VortacDesign/VortacToolchanger/README.md

# VortacToolchanger
Modular toolchanger system for 3D printers – designed for VORON-style machines. Includes mechanical files, wiring guides, firmware configuration and setup scripts.
