VortacDesign/VortacToolchanger/pcb/Vectors/Robi.png

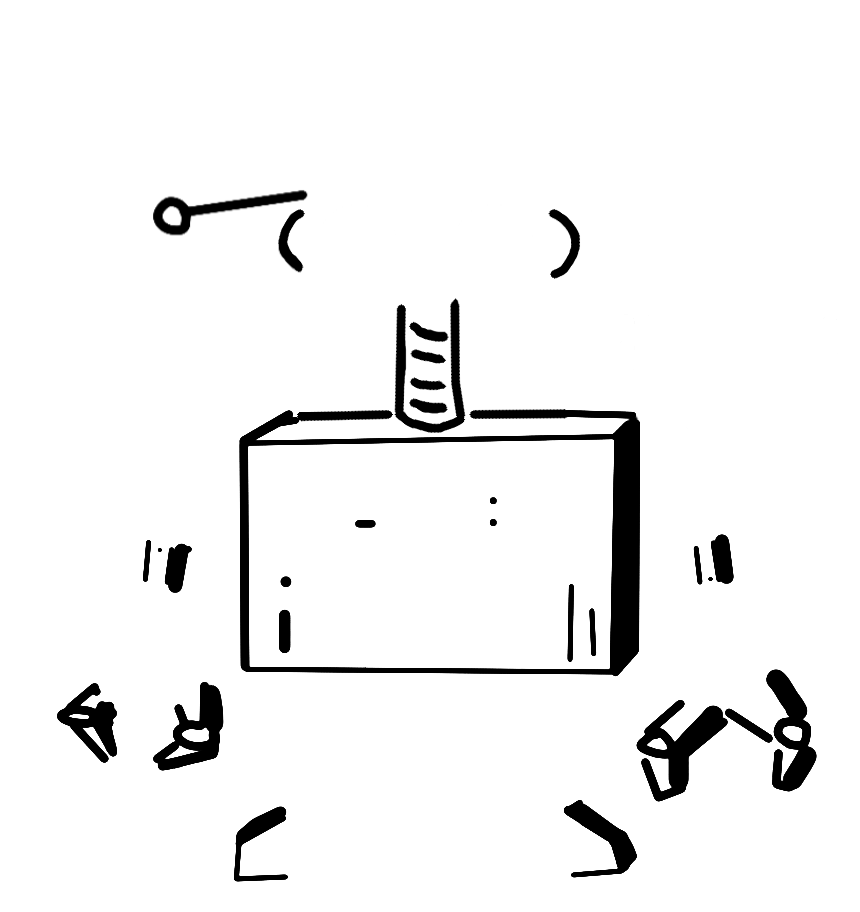
pcb/Vectors/Robi.png
