VortacDesign/VortacToolchanger/pcb/KiCAD/VORTAC_TOOL/production/bom.csv

Designator | Footprint | Quantity | Value | LCSC Part #
D1, D2 | D_SOD-323 | 2 | UDD32C24L01 | C19188728
D5 | D_SOD-123F | 1 | PTVS26VS1UR,115-ES | C41409305
