VortacDesign/VortacToolchanger/pcb/Vectors/PCB  Main.dxf

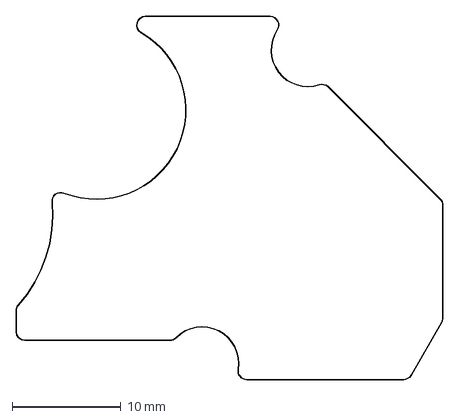
[picture p2: CAD file, 2025-06-08]
pcb/Vectors/PCB Main.dxf
39.2 x 33.4 mm
