VortacDesign/VortacToolchanger/pcb/KiCAD/VORTAC_DOCK_REV1/VORTAC_DOCK_REV1.step

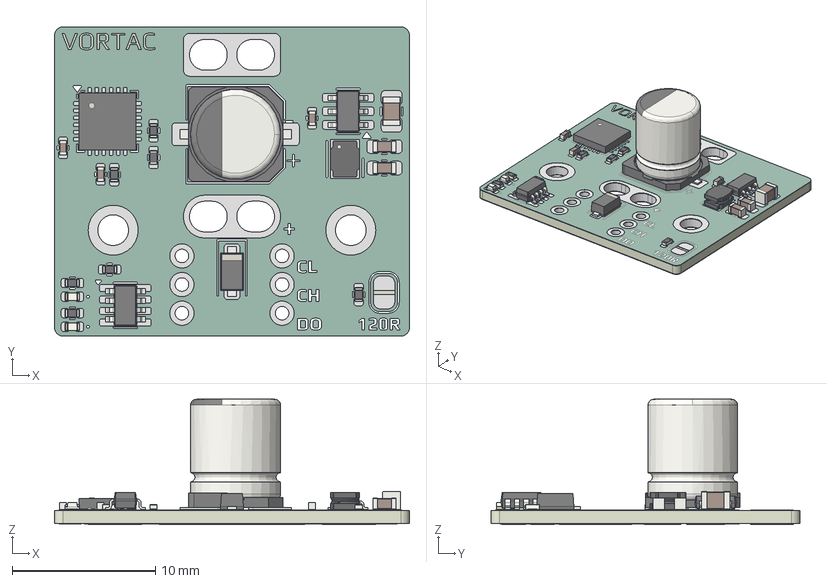
[picture p3: CAD file, 2026-04-23]
pcb/KiCAD/VORTAC_DOCK_REV1/VORTAC_DOCK_REV1.step
24.8 x 21.6 x 8.77 mm
C_0402_1005Metric x 3
R_0402_1005Metric x 7
CP_Elec_6.3x7.7
C_0805_2012Metric
LED_0402_1005Metric x 2
C_0603_1608Metric x 2
D_SOD-123F
SOT-23-8
Texas_RGE0024H_VQFN-24-1EP_4x4mm_P0.5mm_EP2.7x2.7mm
L_Wurth_WE-LQSH-2512
TSOT-23-6
VORTAC_DOCK_REV1_copper
VORTAC_DOCK_REV1_pad
VORTAC_DOCK_REV1_via
VORTAC_DOCK_REV1_silkscreen
VORTAC_DOCK_REV1_soldermask
VORTAC_DOCK_REV1_PCB
