VortacDesign/VortacToolchanger/pcb/KiCAD/VORTAC_PANEL_REV1/production/Panel_DXF.dxf

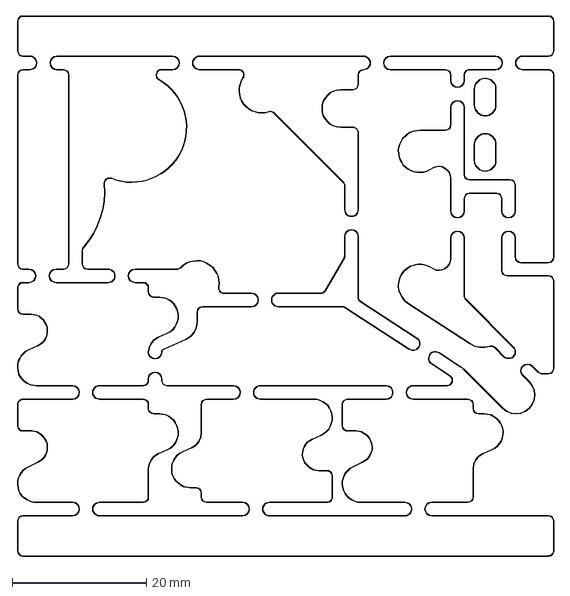
[picture p4: CAD file, 2025-06-08]
pcb/KiCAD/VORTAC_PANEL_REV1/production/Panel_DXF.dxf
80.2 x 80.6 mm
