VortacDesign/VortacToolchanger/pcb/KiCAD/VORTAC_REV1/VORTAC_REV1.step

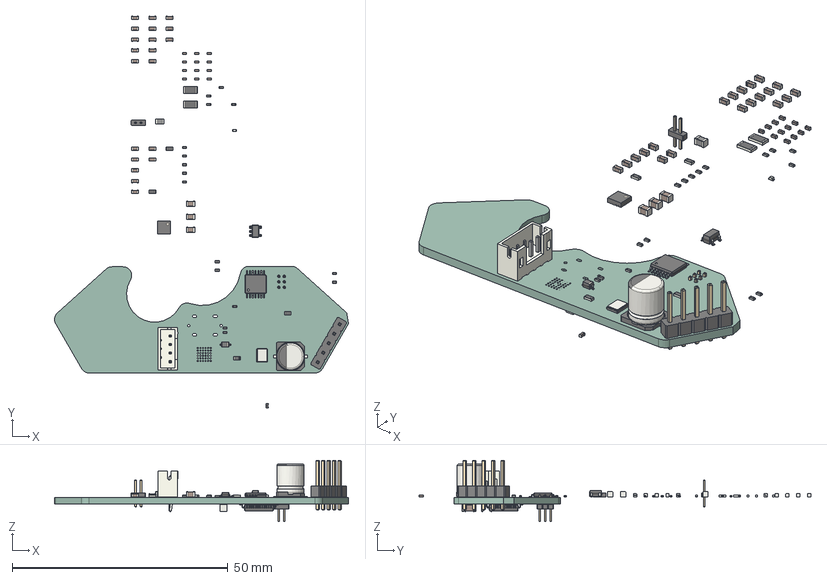
[picture p5: CAD file, 2025-06-08]
pcb/KiCAD/VORTAC_REV1/VORTAC_REV1.step
68.2 x 90.8 x 14.2 mm
C_0805_2012Metric x 3
C_0603_1608Metric x 20
C_0402_1005Metric x 13
R_0402_1005Metric x 19
CP_Elec_63x77
L_0805_2012Metric
R_1206_3216Metric x 2
R_0603_1608Metric x 4
SOT_23_5
D_SOD_323
VSON_10_1EP_3x3mm_Pitch05mm_ThermalPad
PinHeader_2x01_P127mm_Vertical
TSSOP_14_44x5mm_P065mm
LED_0402_1005Metric
JST_B4B_PH_K
PinHeader_1x05_P254mm_Vertical
Crystal_SMD_3225-4Pin_3.2x2.5mm
LQFP_48_7x7mm_P05mm
PinHeader_2x03_P127mm_Vertical
C_1206_3216Metric
_autosave-VORTAC_REV1_PCB
