VortacDesign/VortacToolchanger/pcb/KiCAD/VORTAC_TOOL/VORTAC_TOOL.step

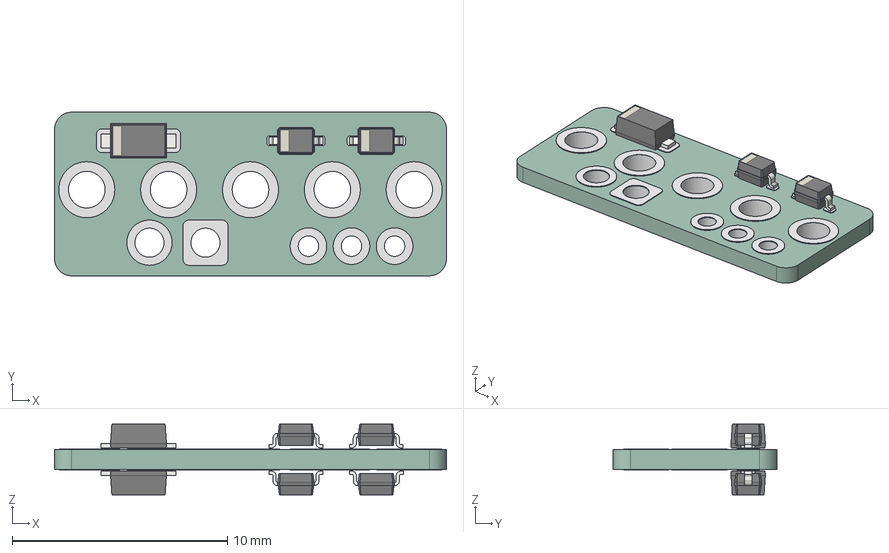
[picture p6: CAD file, 2026-04-22]
pcb/KiCAD/VORTAC_TOOL/VORTAC_TOOL.step
18.2 x 7.60 x 3.28 mm
D_SOD-323 x 4
D_SOD-123F x 2
VORTAC_TOOL_pad
VORTAC_TOOL_PCB
