VortacDesign/VortacToolchanger/pcb/KiCAD/VORTAC_TOOLPLATE_REV2/VORTAC_TOOLPLATE_REV2.step

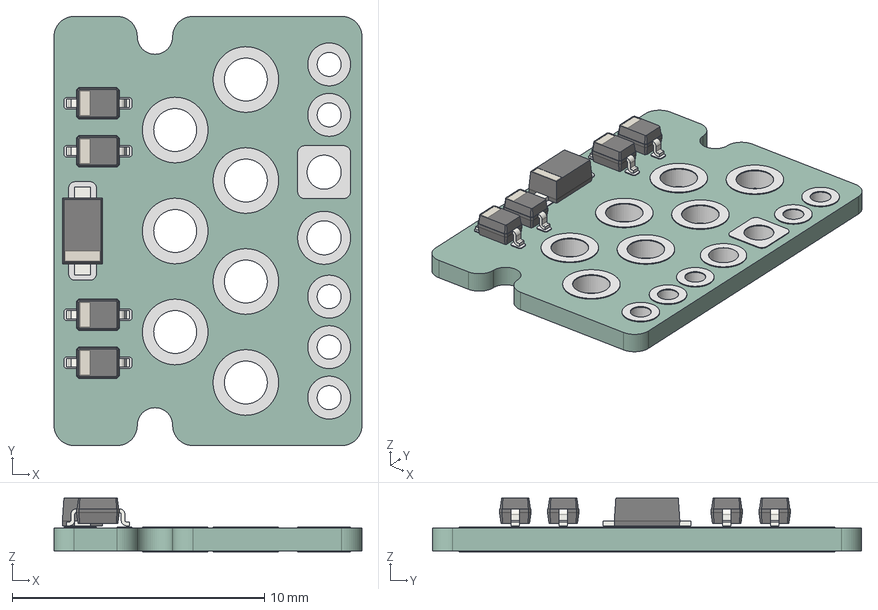
[picture p7: CAD file, 2025-11-01]
pcb/KiCAD/VORTAC_TOOLPLATE_REV2/VORTAC_TOOLPLATE_REV2.step
12.2 x 17.0 x 2.14 mm
D_SOD-323 x 4
D_SOD-123F
VORTAC_TOOLPLATE_REV2_pad
VORTAC_TOOLPLATE_REV2_PCB
