VortacDesign/VortacToolchanger/stl/Vortac_Dock_02_Frame.stl

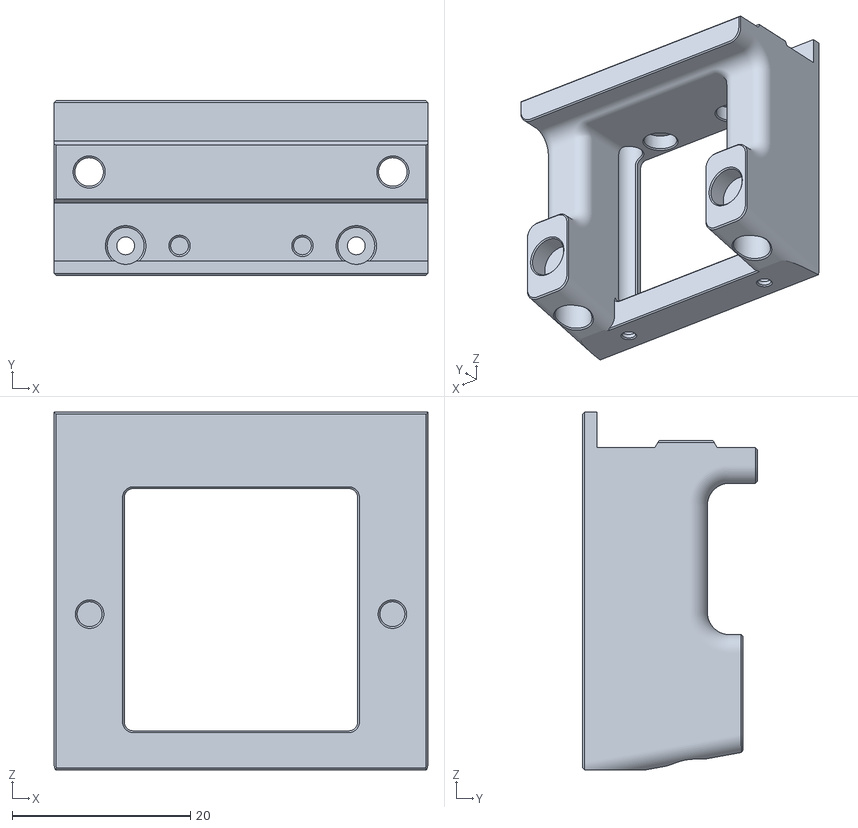
[picture p8: CAD file, 2026-04-23]
stl/Vortac_Dock_02_Frame.stl
42.0 x 19.6 x 40.2
