VortacDesign/VortacToolchanger/pcb/KiCAD/VORTAC_DOCK_REV1/SolderJig_Magnets.stl

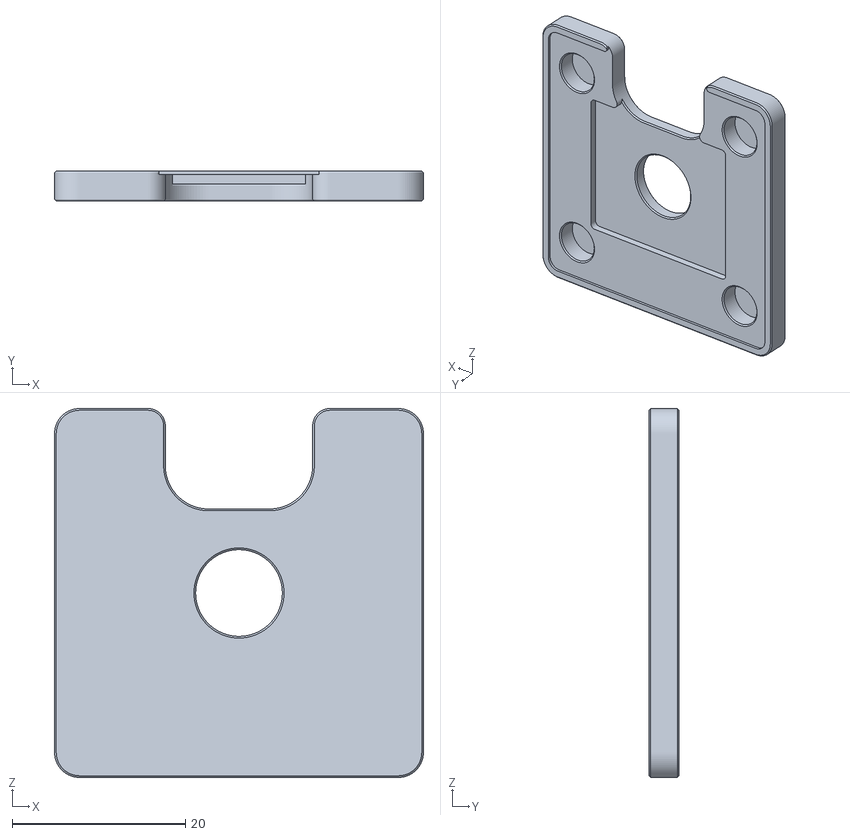
[picture p9: CAD file, 2026-04-22]
pcb/KiCAD/VORTAC_DOCK_REV1/SolderJig_Magnets.stl
42.6 x 3.50 x 42.6
