VortacDesign/VortacToolchanger/pcb/KiCAD/VORTAC_TOOL/OutLine.dxf

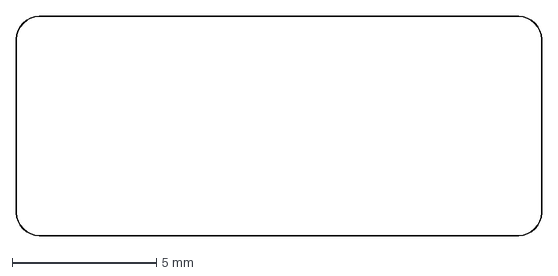
[picture p10: CAD file, 2025-10-04]
pcb/KiCAD/VORTAC_TOOL/OutLine.dxf
18.2 x 7.60 mm
