VortacDesign/VortacToolchanger/pcb/KiCAD/VORTAC_TOOLPLATE_REV2/PCB_Refference.dxf

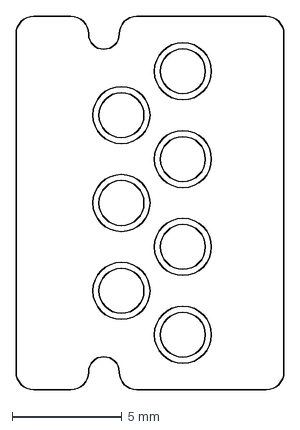
[picture p11: CAD file, 2025-11-01]
pcb/KiCAD/VORTAC_TOOLPLATE_REV2/PCB_Refference.dxf
12.2 x 17.0 mm
