VortacDesign/VortacToolchanger/pcb/Vectors/PCB Clearance.dxf

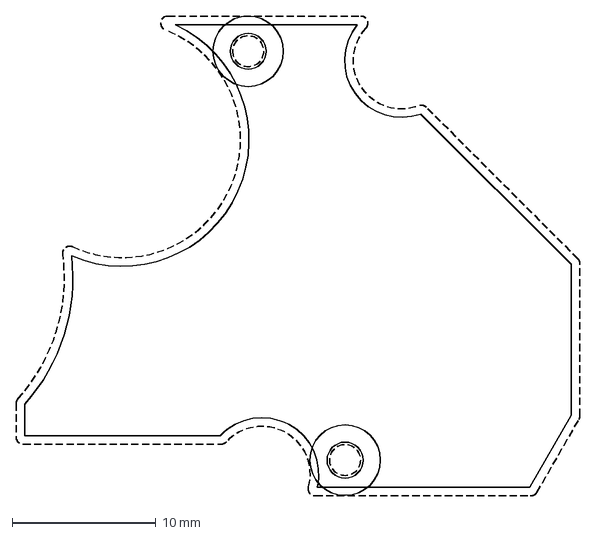
[picture p12: CAD file, 2025-06-08]
pcb/Vectors/PCB Clearance.dxf
39.2 x 33.4 mm
