VortacDesign/VortacToolchanger/stl/Vortac_Dock_02_PogoBar.stl

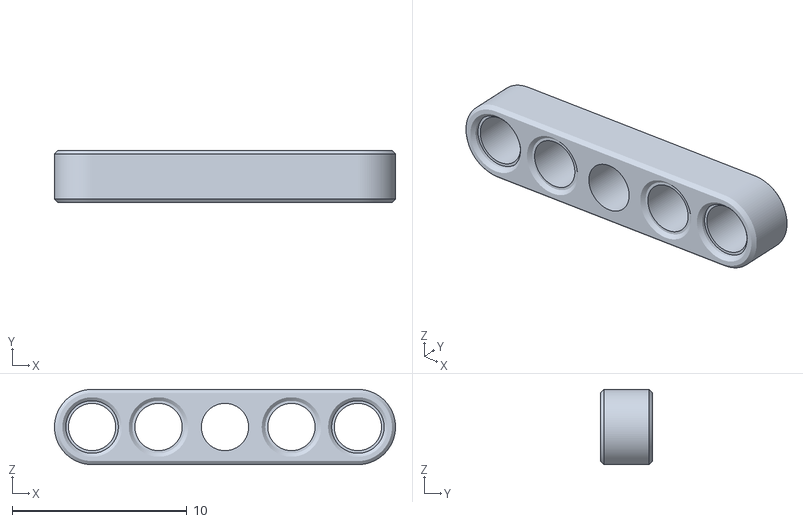
[picture p13: CAD file, 2026-04-23]
stl/Vortac_Dock_02_PogoBar.stl
19.5 x 3.00 x 4.30
