VortacDesign/VortacToolchanger/pcb/KiCAD/VORTAC_DOCK_REV1/SolderJig.stl

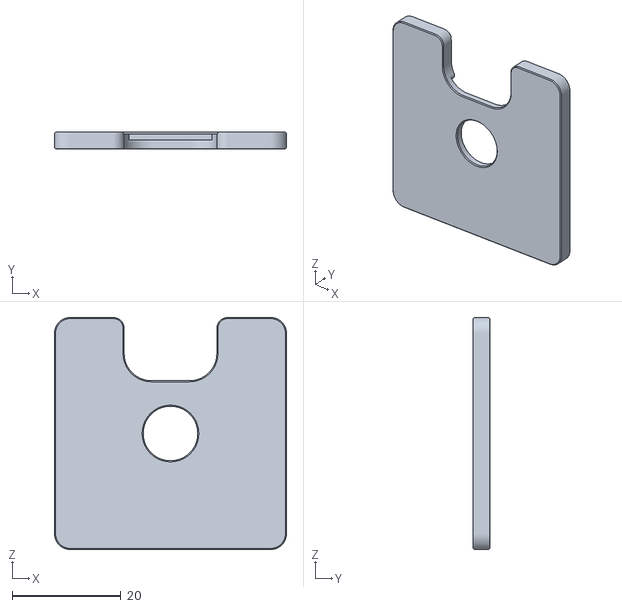
[picture p14: CAD file, 2026-04-22]
pcb/KiCAD/VORTAC_DOCK_REV1/SolderJig.stl
42.6 x 3.10 x 42.6
