VortacDesign/VortacToolchanger/pcb/Vectors/Vortac_Logo.dxf

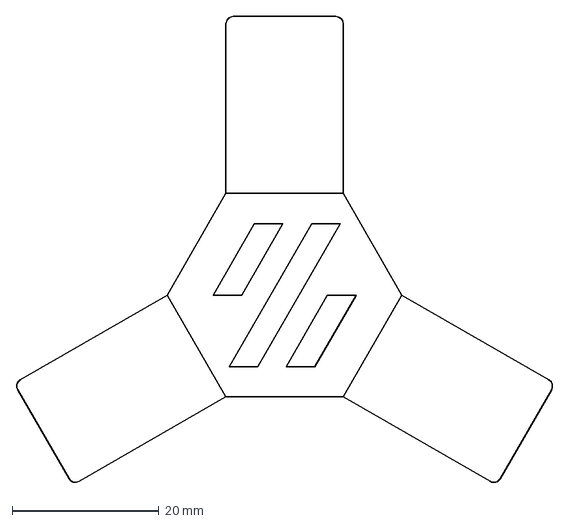
[picture p16: CAD file, 2025-06-08]
pcb/Vectors/Vortac_Logo.dxf
73.3 x 63.7 mm
