VortacDesign/VortacToolchanger/stl/Vortac_Dock_02_Slider.stl

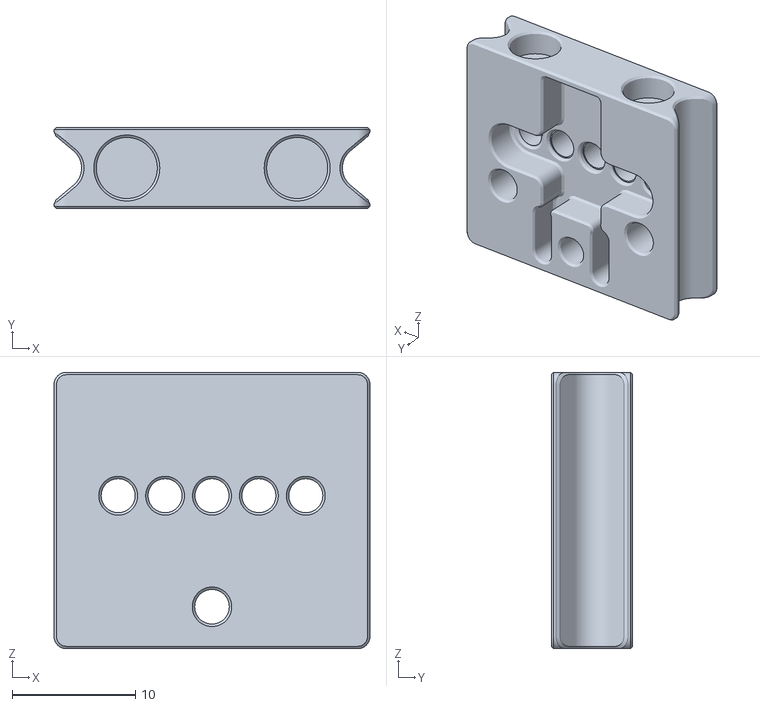
[picture p17: CAD file, 2026-04-23]
stl/Vortac_Dock_02_Slider.stl
25.6 x 6.60 x 22.4
