VortacDesign/VortacToolchanger/pcb/KiCAD/VORTAC_DOCK_REV1/SolderJig_spachelor.stl

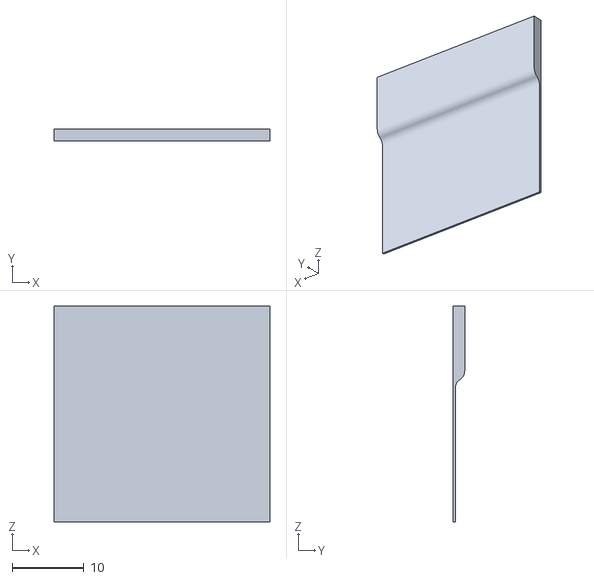
[picture p18: CAD file, 2026-04-22]
pcb/KiCAD/VORTAC_DOCK_REV1/SolderJig_spachelor.stl
30.0 x 1.60 x 30.0
