VortacDesign/VortacToolchanger/pcb/Vectors/PCB Tool.dxf

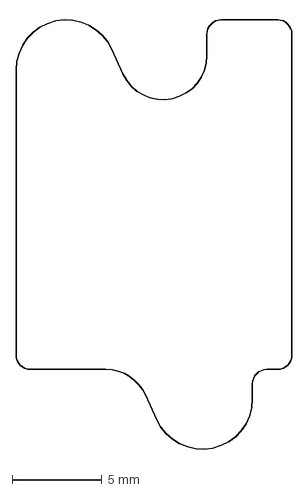
[picture p19: CAD file, 2025-06-08]
pcb/Vectors/PCB Tool.dxf
15.4 x 24.4 mm
