VortacDesign/VortacToolchanger/stl/Vortac_Topplate_003.stl

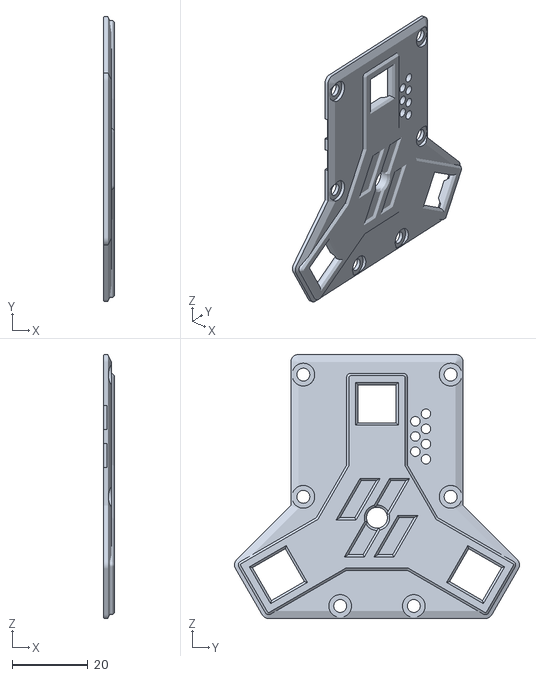
[picture p20: CAD file, 2025-10-04]
stl/Vortac_Topplate_003.stl
3.00 x 75.1 x 69.6
