VortacDesign/VortacToolchanger/pcb/KiCAD/VORTAC_DOCK_REV1/PCB_Outline.dxf

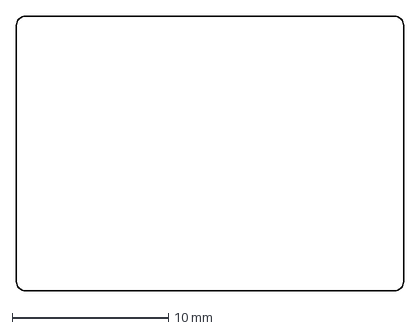
[picture p21: CAD file, 2025-10-30]
pcb/KiCAD/VORTAC_DOCK_REV1/PCB_Outline.dxf
24.8 x 17.6 mm
