VortacDesign/VortacToolchanger/pcb/Vectors/Vortac_Toolchanger_Logo.dxf

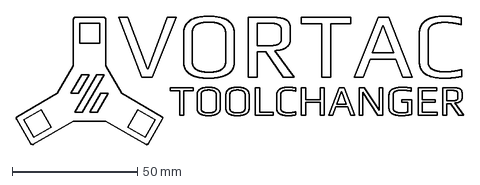
[picture p22: CAD file, 2025-06-08]
pcb/Vectors/Vortac_Toolchanger_Logo.dxf
178.7 x 51.4 mm
