VortacDesign/VortacToolchanger/stl/Vortac_Baseplate_003.stl

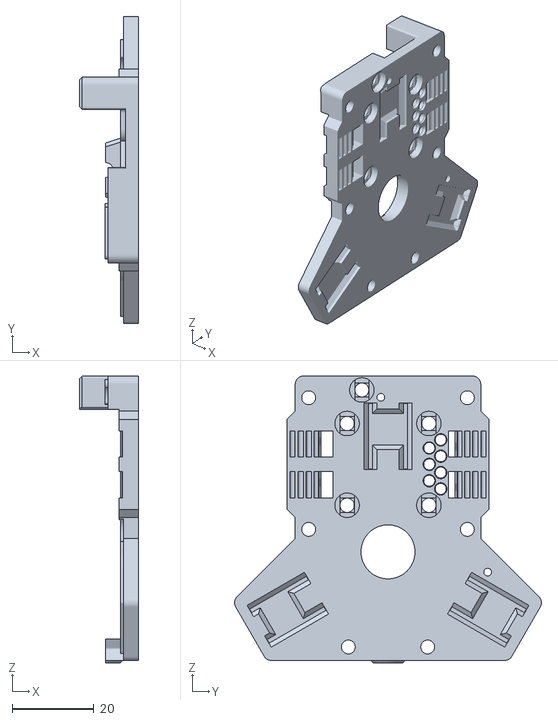
[picture p23: CAD file, 2025-10-04]
stl/Vortac_Baseplate_003.stl
14.4 x 75.1 x 70.2
