VortacDesign/VortacToolchanger/pcb/Vectors/PanelCenter.dxf

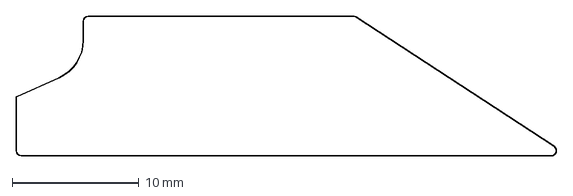
[picture p25: CAD file, 2025-06-08]
pcb/Vectors/PanelCenter.dxf
42.6 x 11.0 mm
