VortacDesign/VortacToolchanger/stl/Vortac_Cable_Anchor_001.stl

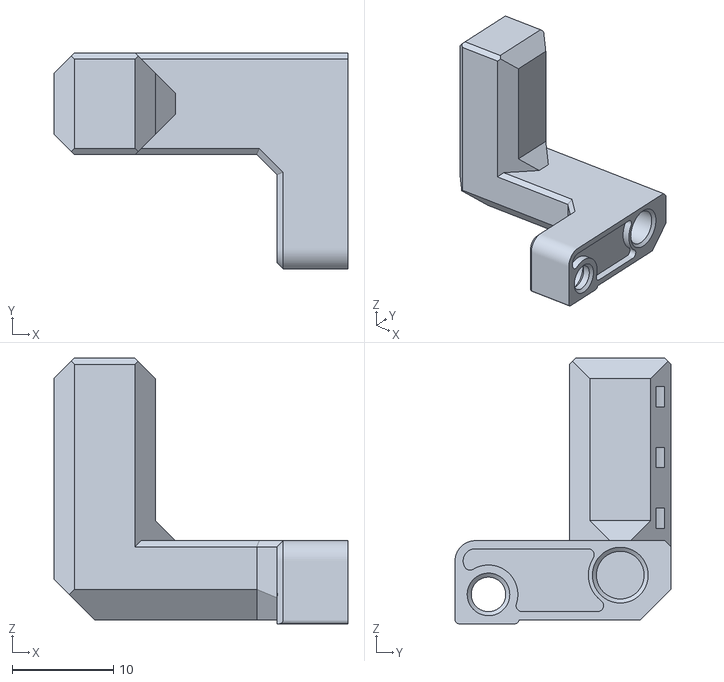
[picture p26: CAD file, 2025-10-04]
stl/Vortac_Cable_Anchor_001.stl
29.0 x 21.3 x 26.2
