VortacDesign/VortacToolchanger/pcb/Vectors/PCB Front.dxf

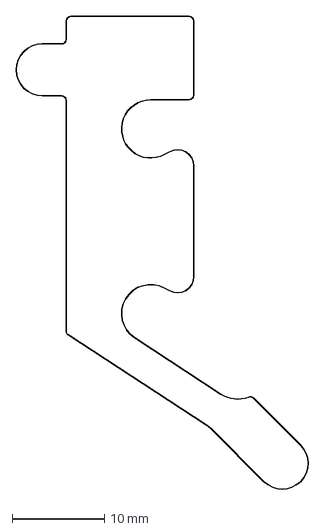
[picture p27: CAD file, 2025-06-08]
pcb/Vectors/PCB Front.dxf
31.9 x 51.5 mm
