VortacDesign/VortacToolchanger/stl/Vortac_001_Back.stl

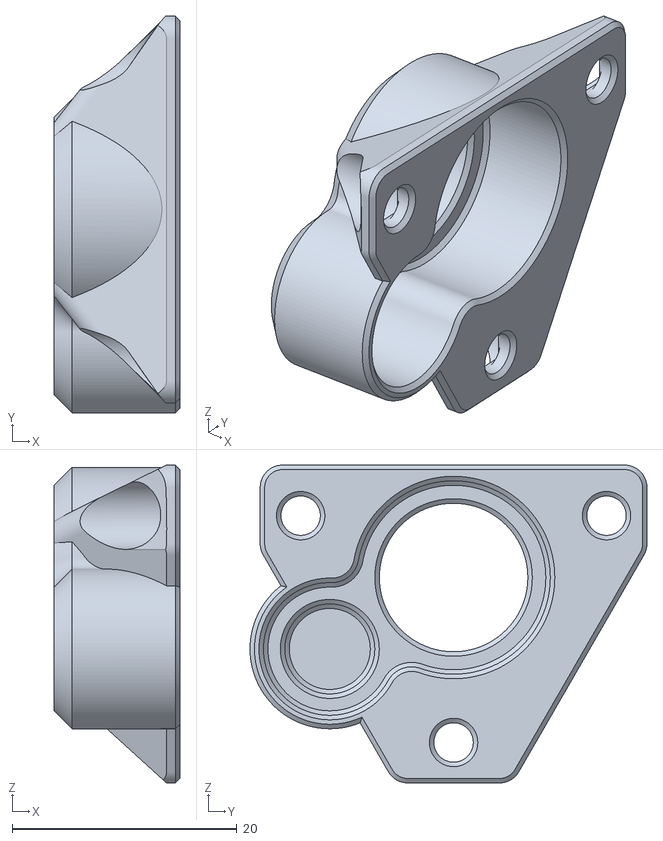
[picture p28: CAD file, 2025-06-09]
stl/Vortac_001_Back.stl
11.2 x 35.3 x 28.3
