VortacDesign/VortacToolchanger/stl/Sensor_Guide.stl

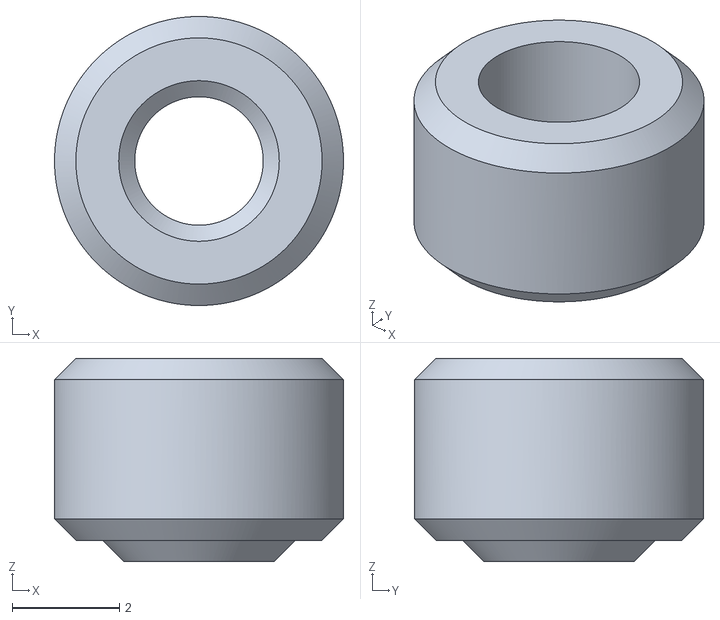
[picture p30: CAD file, 2025-06-09]
stl/Sensor_Guide.stl
5.40 x 5.40 x 3.80
