VortacDesign/VortacToolchanger/stl/Vortac_003_Mid.stl

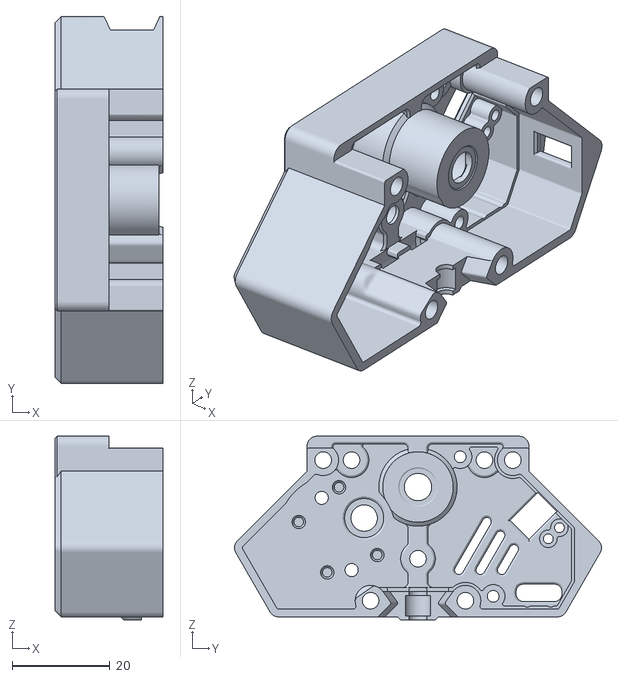
[picture p31: CAD file, 2025-06-09]
stl/Vortac_003_Mid.stl
22.0 x 75.1 x 37.6
