VortacDesign/VortacToolchanger/stl/Vortac_001_Top.stl

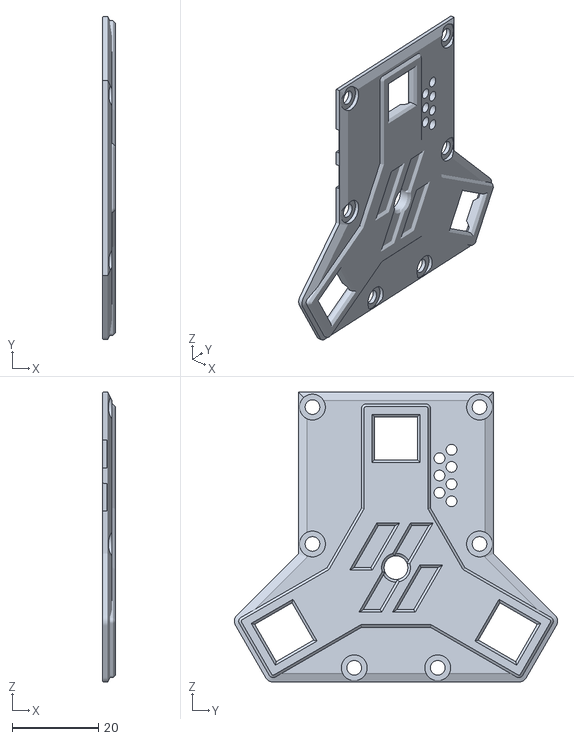
[picture p32: CAD file, 2025-06-09]
stl/Vortac_001_Top.stl
3.00 x 75.1 x 67.4
