VortacDesign/VortacToolchanger/stl/JointX_L_Top_V3.stl

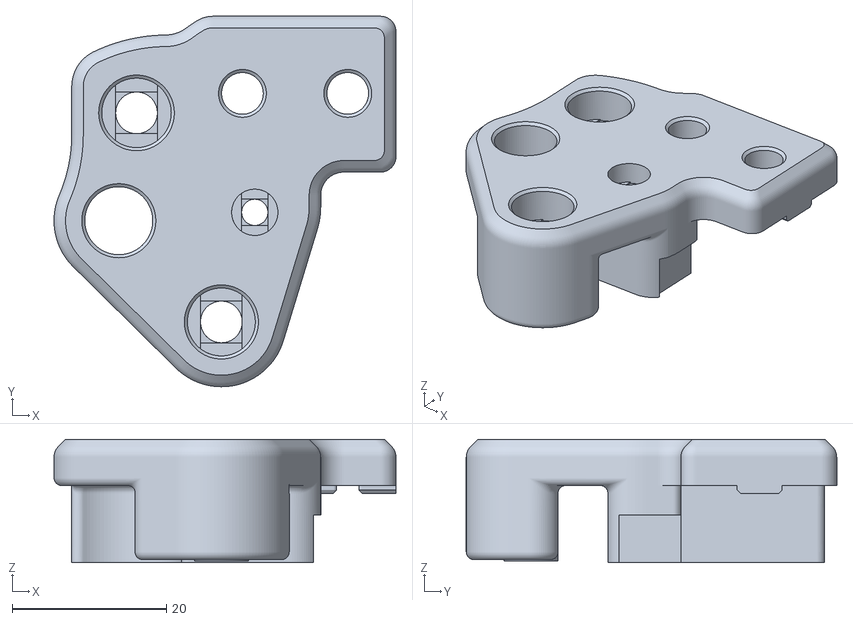
[picture p33: CAD file, 2025-06-09]
stl/JointX_L_Top_V3.stl
44.3 x 48.0 x 16.0
