VortacDesign/VortacToolchanger/stl/JointX_L_Bot_V3.stl

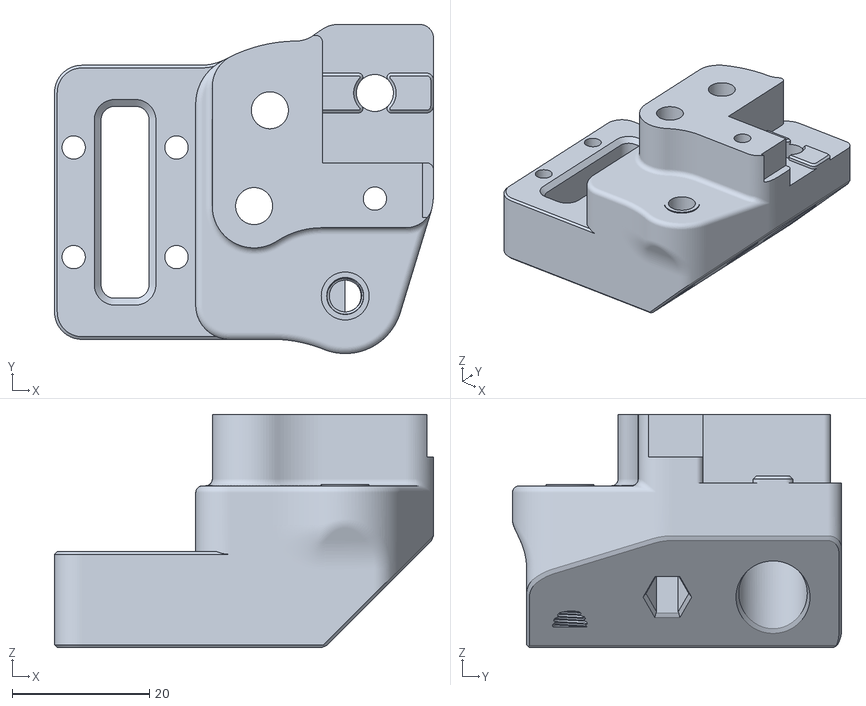
[picture p34: CAD file, 2025-06-09]
stl/JointX_L_Bot_V3.stl
55.3 x 48.0 x 34.0
