VortacDesign/VortacToolchanger/stl/Vortac_Toolplate_002.stl

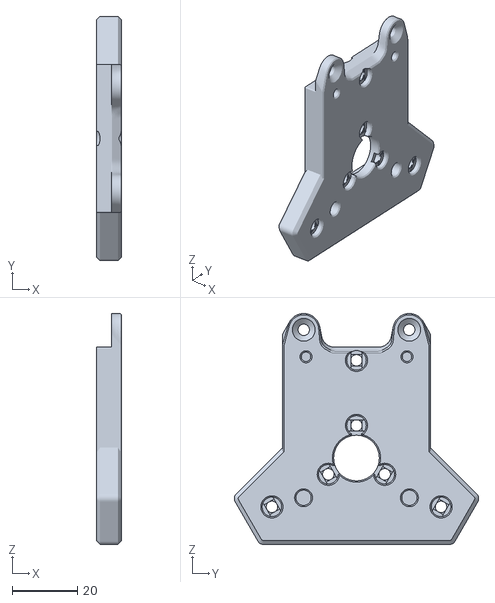
[picture p35: CAD file, 2025-06-09]
stl/Vortac_Toolplate_002.stl
7.80 x 75.1 x 70.9
