VortacDesign/VortacToolchanger/stl/Sensor_Flag.stl

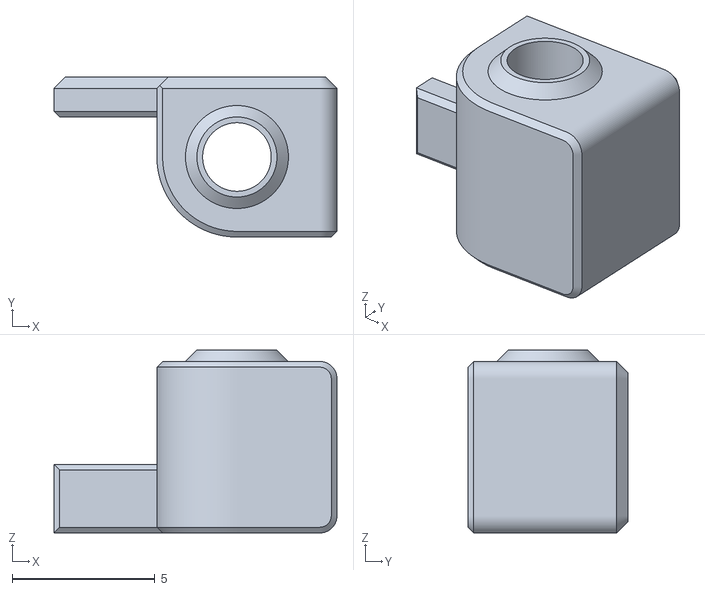
[picture p37: CAD file, 2025-06-09]
stl/Sensor_Flag.stl
9.90 x 5.60 x 6.40
