VortacDesign/VortacToolchanger/(list of files, cad)

Other CAD files:
pcb/KiCAD/VORTAC_TOOLPLATE_REV1/VORTAC_TOOLPLATE_REV1.step
