VortacDesign/VortacToolchanger/pcb/KiCAD/VORTAC_DOCK_REV1/VORTAC_DOCK_REV1.kicad_pcb

## KiCad design pcb/KiCAD/VORTAC_DOCK_REV1/VORTAC_DOCK_REV1.kicad_pcb (2026-04-22)

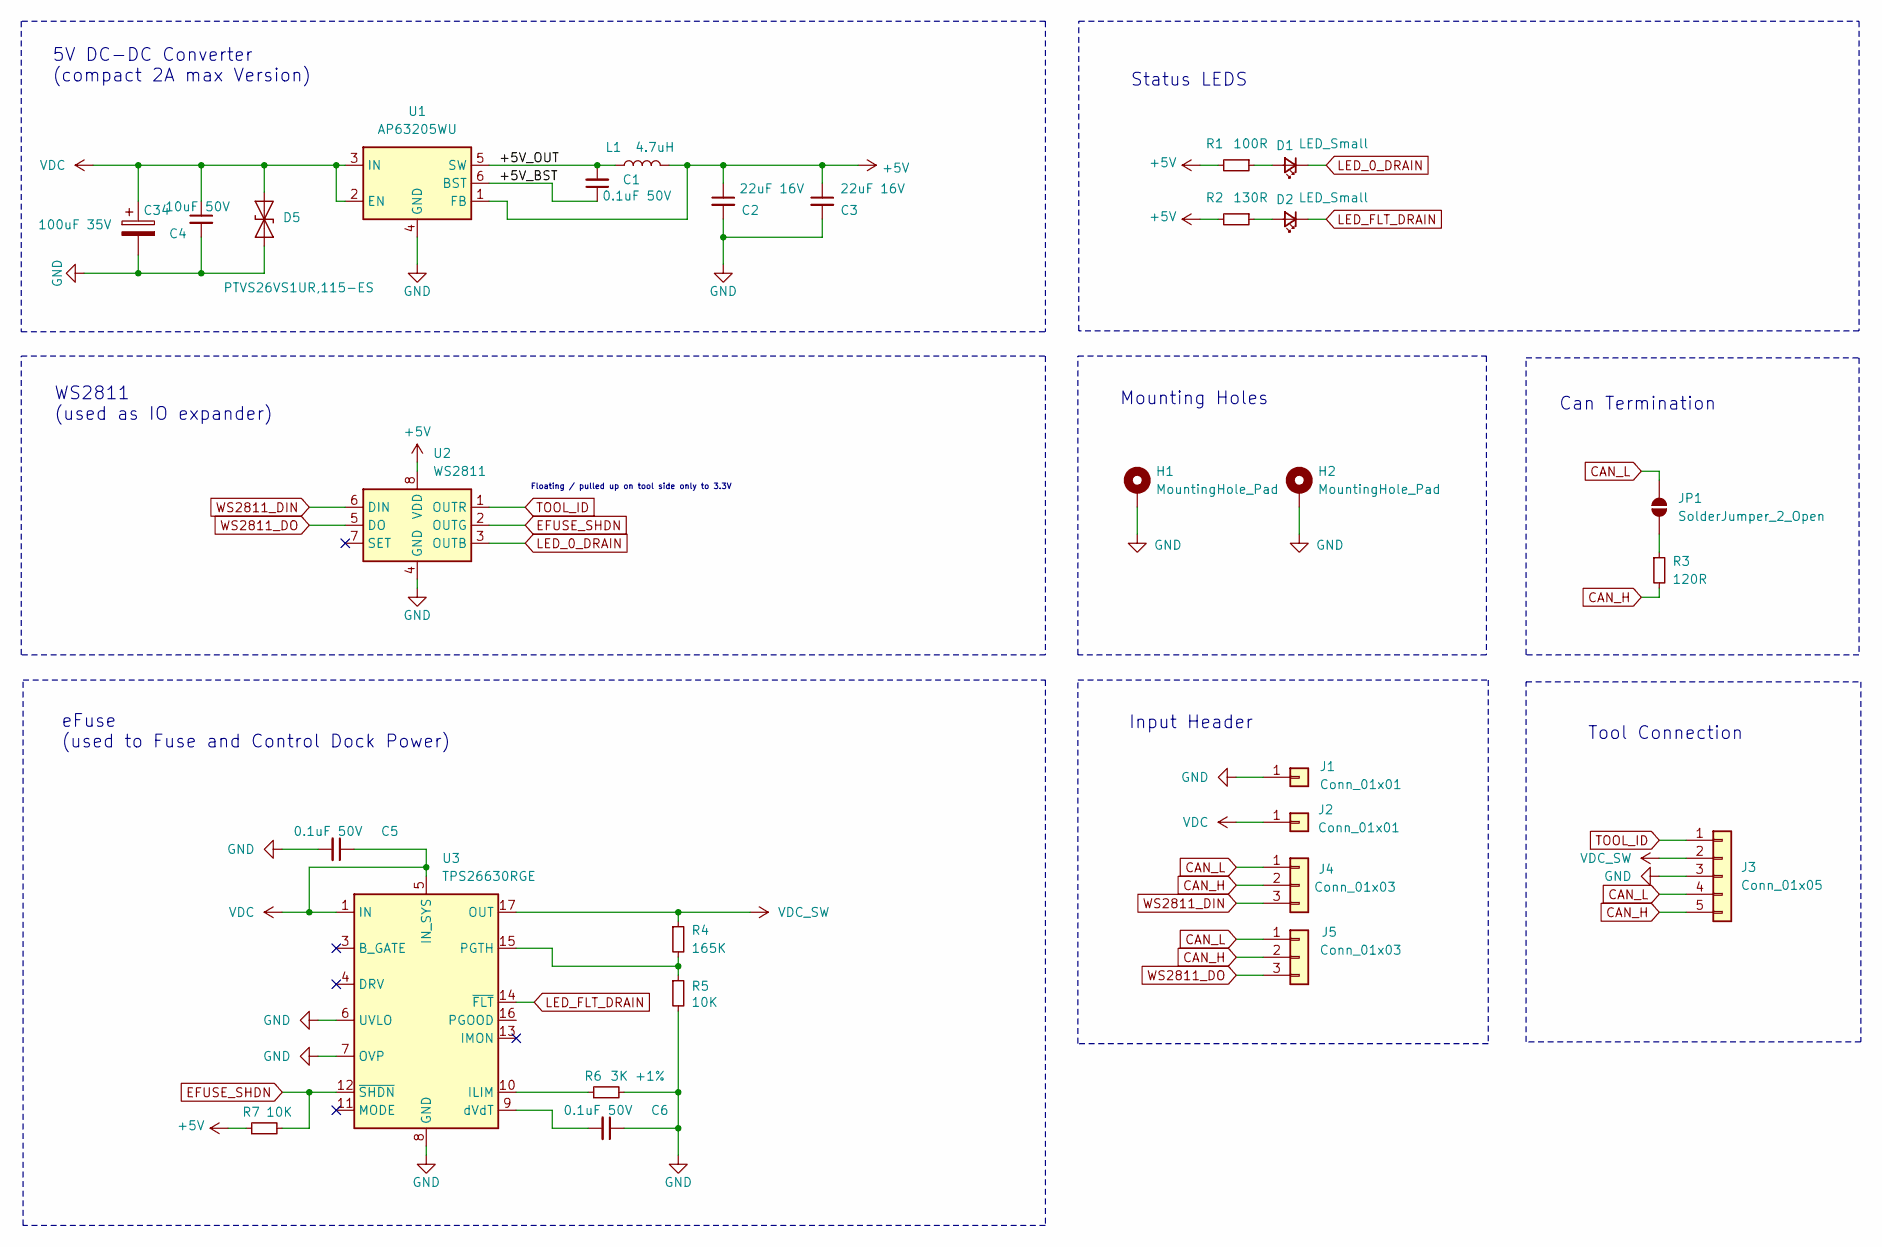
[picture p38: schematic VORTAC_DOCK_REV1.kicad_sch]

Parts:
C1, C5, C6: 0.1uF 50V; C_0402_1005Metric; LCSC C5182432
C2, C3: 22uF 16V; C_0603_1608Metric; LCSC C2762594
C4: 10uF 50V; C_0805_2012Metric; LCSC C440198
C34: 100uF 35V; CP_Elec_6.3x7.7; LCSC C2983388
D1: LED_Small; LED_0402_1005Metric; LCSC C130724
D2: LED_Small; LED_0402_1005Metric; LCSC C130719
D5: PTVS26VS1UR,115-ES; D_SOD-123F; LCSC C41409305
H1, H2: MountingHole_Pad; MountingHole_2.2mm_M2_ISO7380_Pad
J1: Conn_01x01; Dock_Solderpoint_02x01_GND
J2: Conn_01x01; Dock_Solderpoint_02x01_VCC
J3: Conn_01x05; mill-max-0881-1-15-20-82-14-11-0_LandingPads_Simple_01x05
J4, J5: Conn_01x03; Solderpoint_01x03_Data
JP1: SolderJumper_2_Open; SolderJumper-2_P1.3mm_Open_RoundedPad1.0x1.5mm
L1: 4.7uH; L_Wurth_WE-LQSH-2512; LCSC C5832360
R1: 100R; R_0402_1005Metric; LCSC C106232
R2: 130R; R_0402_1005Metric; LCSC C477610
R3: 120R; R_0402_1005Metric; LCSC C114758
R4: 165K; R_0402_1005Metric; LCSC C38706
R5, R7: 10K; R_0402_1005Metric; LCSC C60490
R6: 3K +1%; R_0402_1005Metric; LCSC C137987
U1: AP63205WU; TSOT-23-6; LCSC C2071056
U2: WS2811; SOT-23-8; 8mm pitch; LCSC C5446692
U3: TPS26630RGE; Texas_RGE0024H_VQFN-24-1EP_4x4mm_P0.5mm_EP2.7x2.7mm_Thermal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; LCSC C1850276

Connections:
+5V: C2.1, C3.1, L1.2, R1.2, R2.2, R7.1, U1.1 (FB), U2.8 (VDD)
/+5V_BST: C1.1, U1.6 (BST)
/+5V_OUT: C1.2, L1.1, U1.5 (SW)
CAN_H: J3.5, J4.2, J5.2, R3.2
CAN_L: J3.4, J4.1, J5.1, JP1.2 (B)
EFUSE_SHDN: R7.2, U2.2 (OUTG), U3.12 (~SHDN)
GND: C2.2, C3.2, C4.2, C5.2, C6.1, C34.2, D5.2 (A2), H1.1, H2.1, J1.1, J3.3, R5.2, R6.2, U1.4 (GND), U2.4 (GND), U3.6 (UVLO), U3.7 (OVP), U3.8 (GND), U3.25 (GND)
LED_0_DRAIN: D1.1 (K), U2.3 (OUTB)
LED_FLT_DRAIN: D2.1 (K), U3.14 (~FLT)
unnamed: D1.2 (A), R1.1
unnamed: D2.2 (A), R2.1
unnamed: JP1.1 (A), R3.1
unnamed: R6.1, U3.10 (ILIM)
unnamed: R4.2, R5.1, U3.15 (PGTH)
unnamed: C6.2, U3.9 (dVdT)
TOOL_ID: J3.1, U2.1 (OUTR)
VDC: C4.1, C5.1, C34.1, D5.1 (A1), J2.1, U1.2 (EN), U1.3 (IN), U3.1 (IN), U3.2 (IN), U3.5 (IN_SYS)
VDC_SW: J3.2, R4.1, U3.17 (OUT), U3.18 (OUT)
WS2811_DIN: J4.3, U2.6 (DIN)
WS2811_DO: J5.3, U2.5 (DO)

Notes on the sheet:
Tool Connection
Floating / pulled up on tool side only to 3.3V
Status LEDS
Mounting Holes
WS2811 (used as IO expander)
Can Termination
eFuse (used to Fuse and Control Dock Power)
5V DC-DC Converter (compact 2A max Version)
Input Header

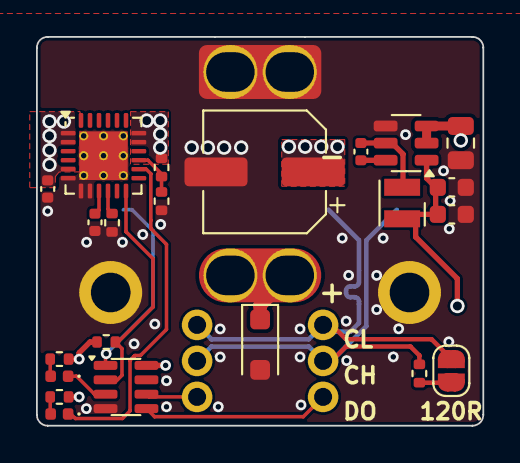
[picture p39: board VORTAC_DOCK_REV1.kicad_pcb from above]

Board: 4 copper layers, 24.8 x 21.6 mm, 29 parts (1 on the bottom side), 20 nets.
