VortacDesign/VortacToolchanger/pcb/KiCAD/VORTAC_TOOLPLATE_REV2/VORTAC_TOOLPLATE_REV2.kicad_pcb

## KiCad design pcb/KiCAD/VORTAC_TOOLPLATE_REV2/VORTAC_TOOLPLATE_REV2.kicad_pcb (2025-11-02)

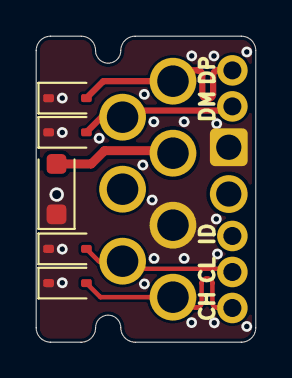
[picture p40: board VORTAC_TOOLPLATE_REV2.kicad_pcb from above]

Board: 4 copper layers, 12.2 x 17.0 mm, 9 parts (0 on the bottom side), 7 nets.

Parts:
D1, D2: UDD32C24L01; D_SOD-323
D3, D4: SD05; D_SOD-323
D9: PTVS26VS1UR,115-ES; D_SOD-123F
J1: Conn_01x07; mill-max-0881-1-15-20-82-14-11-0_LandingPads_ContactPad_PTH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
J2: Conn_01x02; Toolplate_Solderpoint_01x02_Power_Small
J4: Conn_01x02; Toolplate_Solderpoint_01x02_Data_Small
J5: Conn_01x03; Toolplate_Solderpoint_01x03_Data_Small

Connections:
CAN_H: D2.2 (A2), J1.7, J5.3
CAN_L: D1.2 (A2), J1.6, J5.2
GND: D1.1 (A1), D2.1 (A1), D3.1 (A1), D4.1 (A1), D9.1 (A1), J1.5, J2.1
TOOL_ID: J1.4, J5.1
USB_90_D+: D3.2 (A2), J1.1, J4.1
USB_90_D-: D4.2 (A2), J1.2, J4.2
VDC: D9.2 (A2), J1.3, J2.2
