VortacDesign/VortacToolchanger/pcb/KiCAD/VORTAC_TOOL/VORTAC_TOOL.kicad_pcb

## KiCad design pcb/KiCAD/VORTAC_TOOL/VORTAC_TOOL.kicad_pcb (2025-11-02)

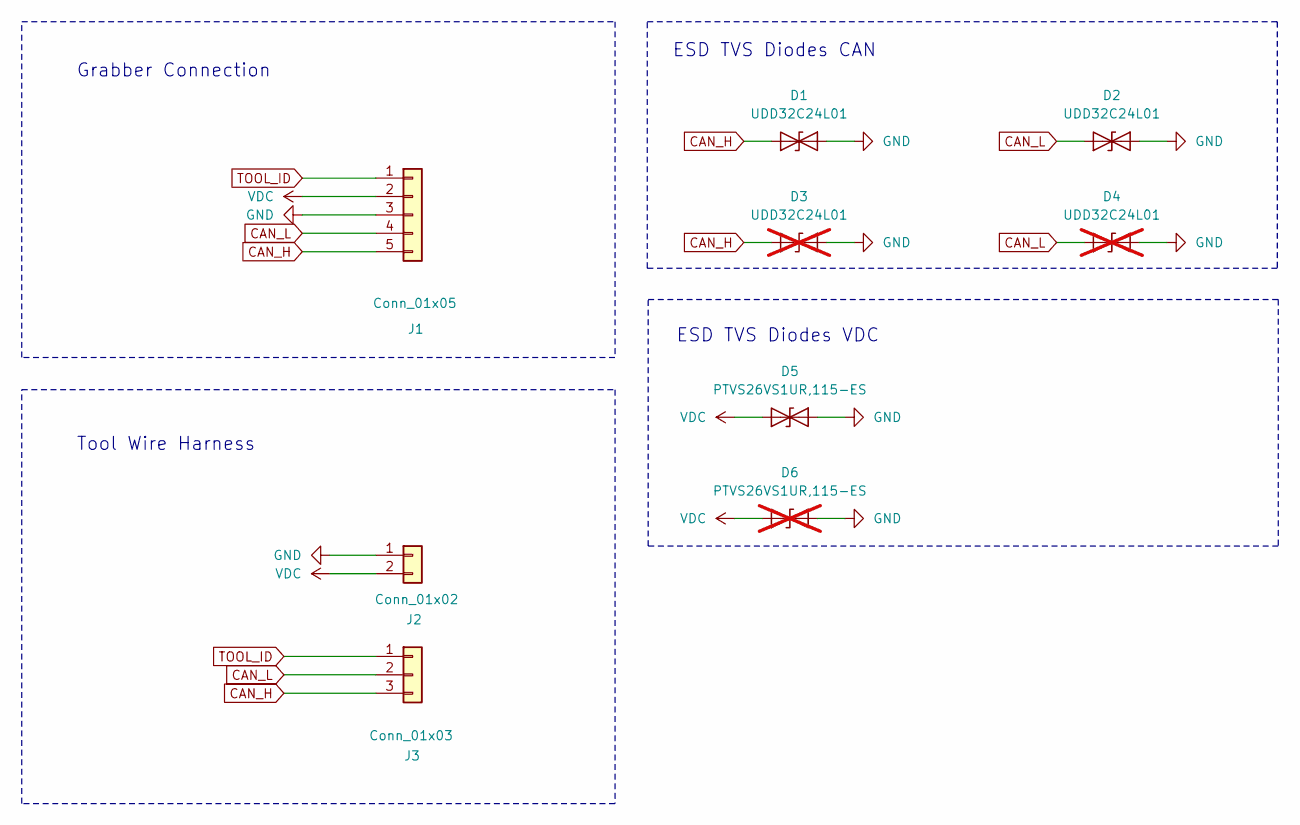
[picture p41: schematic VORTAC_TOOL.kicad_sch]

Parts:
D1, D2: UDD32C24L01; D_SOD-323; LCSC C19188728
D3, D4: UDD32C24L01; D_SOD-323; LCSC C19188728; not fitted
D5: PTVS26VS1UR,115-ES; D_SOD-123F; LCSC C41409305
D6: PTVS26VS1UR,115-ES; D_SOD-123F; LCSC C41409305; not fitted
J1: Conn_01x05; mill-max-0881-1-15-20-82-14-11-0_LandingPads_ContactPad_1x5
J2: Conn_01x02; Toolplate_Solderpoint_01x02_Power_Small
J3: Conn_01x03; Toolplate_Solderpoint_01x03_Data_Small

Connections:
CAN_H: D1.2 (A2), D3.2 (A2), J1.5, J3.3
CAN_L: D2.2 (A2), D4.2 (A2), J1.4, J3.2
GND: D1.1 (A1), D2.1 (A1), D3.1 (A1), D4.1 (A1), D5.1 (A1), D6.1 (A1), J1.3, J2.1
TOOL_ID: J1.1, J3.1
VDC: D5.2 (A2), D6.2 (A2), J1.2, J2.2

Notes on the sheet:
Grabber Connection
ESD TVS Diodes VDC
Tool Wire Harness
ESD TVS Diodes CAN

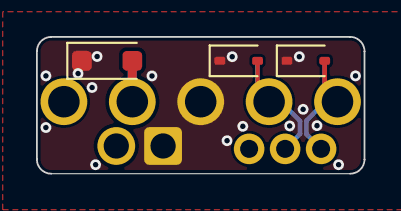
[picture p42: board VORTAC_TOOL.kicad_pcb from above]

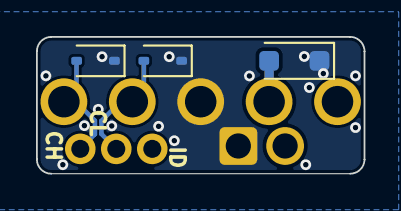
[picture p43: board VORTAC_TOOL.kicad_pcb from below]

Board: 4 copper layers, 18.2 x 7.6 mm, 9 parts (6 on the bottom side), 5 nets.
