VortacDesign/VortacToolchanger/pcb/KiCAD/VORTAC_FRONT_REV1/VORTAC_FRONT_REV1.kicad_pcb

## KiCad design pcb/KiCAD/VORTAC_FRONT_REV1/VORTAC_FRONT_REV1.kicad_pcb (2025-10-04)

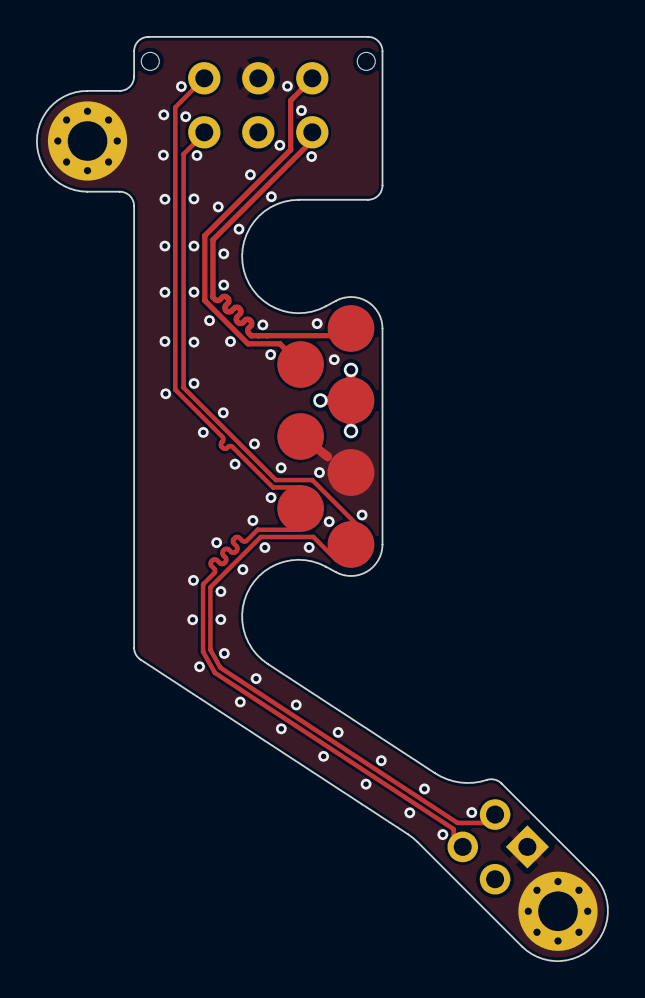
[picture p46: board VORTAC_FRONT_REV1.kicad_pcb from above]

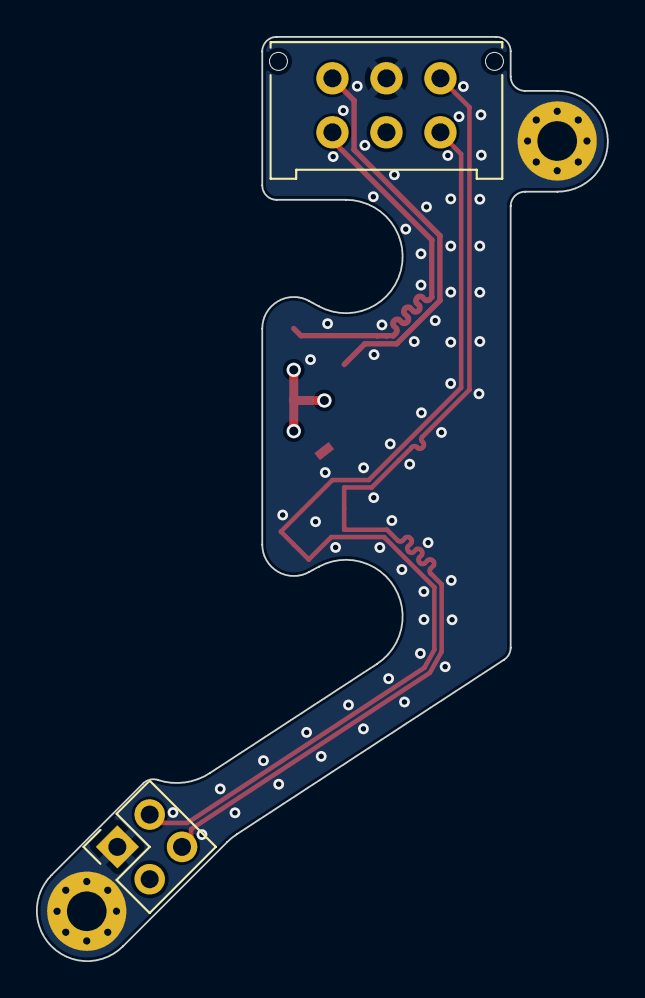
[picture p47: board VORTAC_FRONT_REV1.kicad_pcb from below]

Board: 4 copper layers, 31.7 x 51.3 mm, 6 parts (2 on the bottom side), 7 nets.

Parts:
H1, H2: MountingHole_Pad; MountingHole_2.2mm_M2_Pad_Via_NTR
J1: Conn_02x02_Odd_Even; PinSocket_2x02_P2.54mm_Vertical
J2: Conn_02x03_Odd_Even; Molex_Micro-Fit_3.0_43045-0612_2x03_P3.00mm_Vertical
J3: Conn_01x07; mill-max-0881-1-15-20-82-14-11-0_LandingPads_Simple
NT1: NetTie_2; NetTie-2_SMD_Pad0.5mm

Connections:
CAN_H: J1.3, J2.1, J3.7
CAN_L: J1.4, J2.4, J3.6
GND: H1.1, H2.1, J1.1, J2.5, J3.5, NT1.2
TOOL_ID: J3.4, NT1.1
USB_D+: J2.3, J3.1
USB_D-: J2.6, J3.2
VDC: J1.2, J2.2, J3.3
