VortacDesign/VortacToolchanger/pcb/KiCAD/VORTAC_REV1/VORTAC_REV1.kicad_pcb

## KiCad design pcb/KiCAD/VORTAC_REV1/VORTAC_REV1.kicad_pcb (2025-06-08)

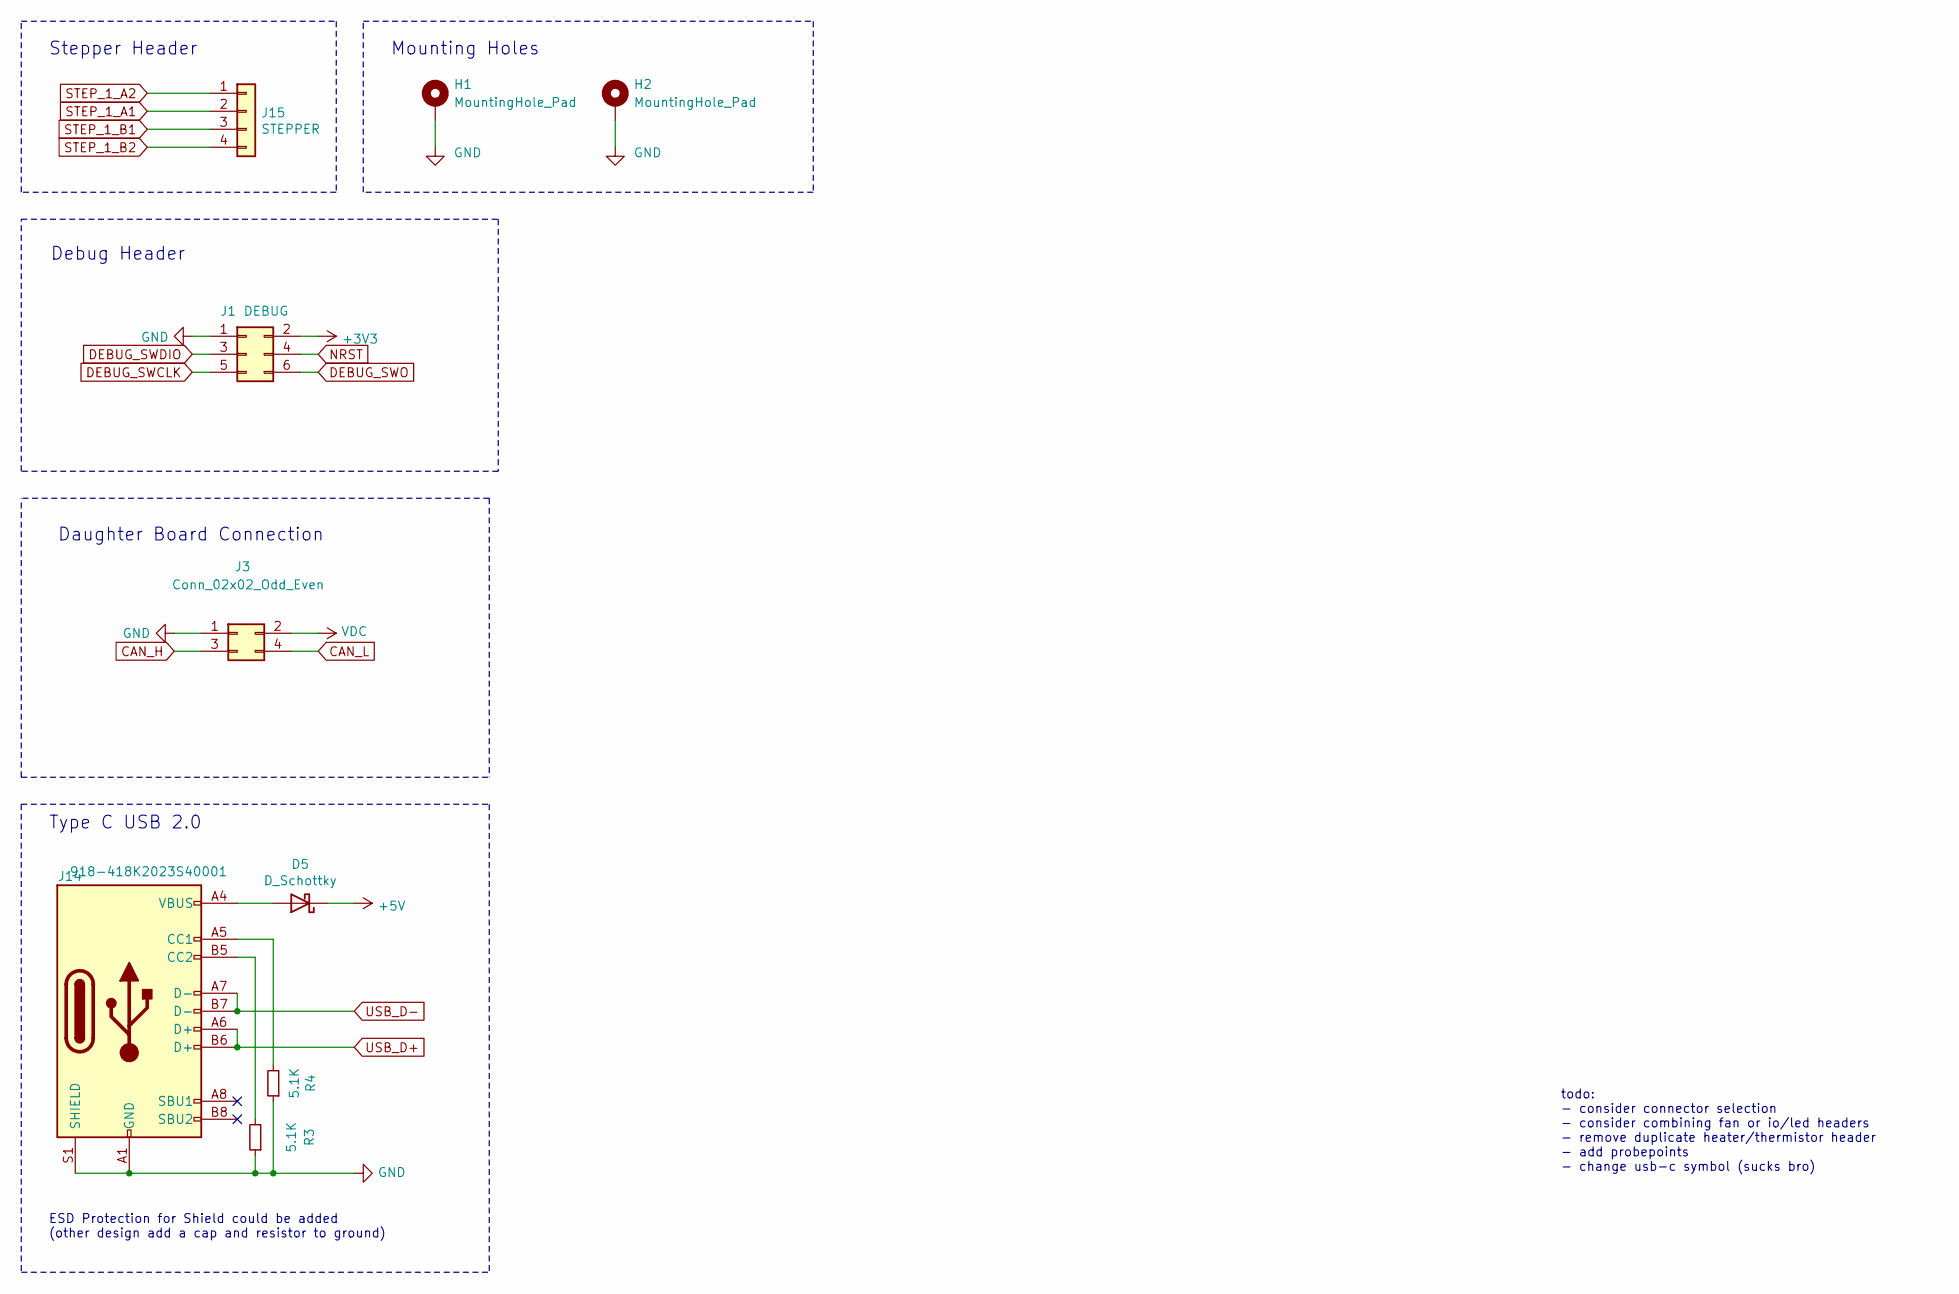
[picture p48: schematic Headers.kicad_sch, Headers & Tool Interfacing]

Parts:
D5: D_Schottky; D_SOD-323; LCSC C7420331
H1, H2: MountingHole_Pad; MountingHole_2.2mm_M2_Pad_Via_NTR
J1: DEBUG; PinSocket_2x03_P2.54mm_Vertical; LCSC C541853
J3: Conn_02x02_Odd_Even; PinHeader_2x02_P2.54mm_Vertical; LCSC C7501273
J14: 918-418K2023S40001; USB-C-SMD_TYPEC-303-ACP16; LCSC C720628
J15: STEPPER; Motor_Hand_Wire_pads
R3, R4: 5.1K; R_0402_1005Metric; LCSC C105872

Connections:
+3V3: J1.2; also elsewhere on the board
+5V: D5.1 (K); also elsewhere on the board
CAN_H: J3.3; also elsewhere on the board
CAN_L: J3.4; also elsewhere on the board
DEBUG_SWCLK: J1.5; also elsewhere on the board
DEBUG_SWDIO: J1.3; also elsewhere on the board
DEBUG_SWO: J1.6; also elsewhere on the board
GND: H1.1, H2.1, J1.1, J3.1, J14.A1 (GND), J14.A12 (GND), J14.B1 (GND), J14.B12 (GND), J14.S1 (SHIELD), R3.1, R4.1; also elsewhere on the board
NRST: J1.4; also elsewhere on the board
unnamed: D5.2 (A), J14.A4 (VBUS), J14.A9 (VBUS), J14.B4 (VBUS), J14.B9 (VBUS)
unnamed: J14.A5 (CC1), R4.2
unnamed: J14.B5 (CC2), R3.2
STEP_1_A1: J15.2; also elsewhere on the board
STEP_1_A2: J15.1; also elsewhere on the board
STEP_1_B1: J15.3; also elsewhere on the board
STEP_1_B2: J15.4; also elsewhere on the board
USB_D+: J14.A6 (D+), J14.B6 (D+); also elsewhere on the board
USB_D-: J14.A7 (D-), J14.B7 (D-); also elsewhere on the board
VDC: J3.2; also elsewhere on the board

Notes on the sheet:
todo: - consider connector selection - consider combining fan or io/led headers - remove duplicate heater/thermistor header - add probepoints - change usb-c symbol (sucks bro)
Daughter Board Connection
Stepper Header
Debug Header
Type C USB 2.0
ESD Protection for Shield could be added (other design add a cap and resistor to ground)
Mounting Holes

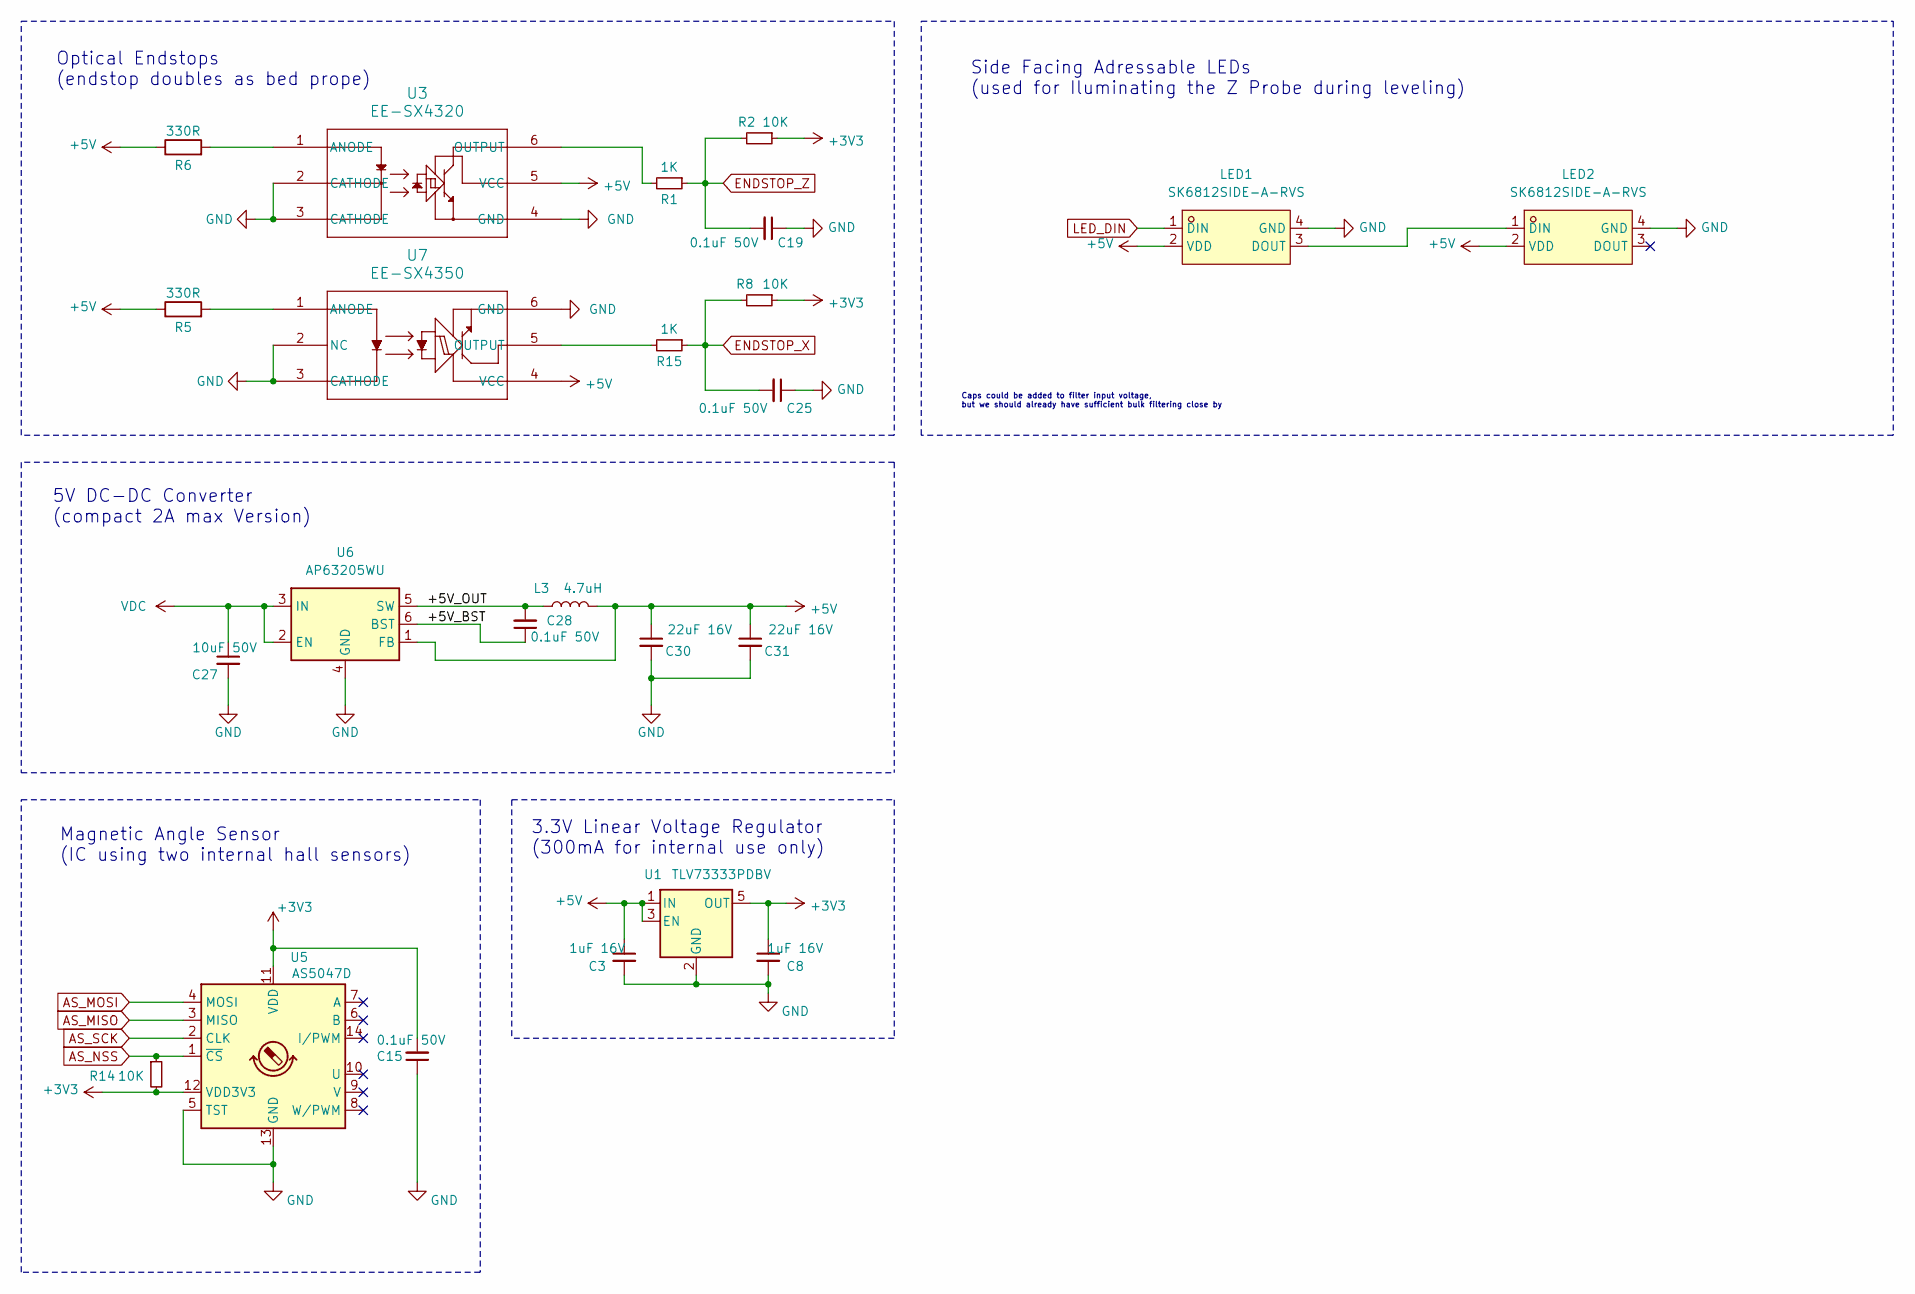
[picture p49: schematic Logic.kicad_sch, Power Management & Control]

Parts:
C3, C8: 1uF 16V; C_0603_1608Metric; LCSC C106248
C15, C19, C25, C28: 0.1uF 50V; C_0402_1005Metric; LCSC C5182432
C27: 10uF 50V; C_0805_2012Metric; LCSC C440198
C30, C31: 22uF 16V; C_0603_1608Metric; LCSC C2762594
L3: 4.7uH; IND-SMD_L4.0-W4.0_FNR40XXS; LCSC C167874
LED1, LED2: SK6812SIDE-A-RVS; LED-SMD_4P-L4.0-W1.6-L; LCSC C2890037
R1, R15: 1K; R_0402_1005Metric; LCSC C106235
R2, R8, R14: 10K; R_0402_1005Metric; LCSC C60490
R5, R6: 330R; R_0402_1005Metric; LCSC C6117577
U1: TLV73333PDBV; SOT-23-5; LCSC C408972
U3: EE-SX4320; SENSOR_EE-SX4320_OMR; LCSC C469129
U5: AS5047D; TSSOP-14_4.4x5mm_P0.65mm; LCSC C2693743
U6: AP63205WU; TSOT-23-6; LCSC C2071056
U7: EE-SX4350; SENSOR_EE-SX3350_OMR; LCSC C17524058

Connections:
+3V3: C8.1, C15.2, R2.1, R8.1, R14.2, U1.5 (OUT), U5.11 (VDD), U5.12 (VDD3V3); also elsewhere on the board
+5V: C3.1, C30.1, C31.1, L3.2, LED1.2 (VDD), LED2.2 (VDD), R5.1, R6.1, U1.1 (IN), U1.3 (EN), U3.5 (VCC), U6.1 (FB), U7.4 (VCC); also elsewhere on the board
/Logic/+5V_BST: C28.1, U6.6 (BST)
/Logic/+5V_OUT: C28.2, L3.1, U6.5 (SW)
AS_MISO: U5.3 (MISO); also elsewhere on the board
AS_MOSI: U5.4 (MOSI); also elsewhere on the board
AS_NSS: R14.1, U5.1 (~CS); also elsewhere on the board
AS_SCK: U5.2 (CLK); also elsewhere on the board
ENDSTOP_X: C25.2, R8.2, R15.1; also elsewhere on the board
ENDSTOP_Z: C19.2, R1.1, R2.2; also elsewhere on the board
GND: C3.2, C8.2, C15.1, C19.1, C25.1, C27.2, C30.2, C31.2, LED1.4 (GND), LED2.4 (GND), U1.2 (GND), U3.2 (CATHODE), U3.3 (CATHODE), U3.4 (GND), U5.5 (TST), U5.13 (GND), U6.4 (GND), U7.2 (NC), U7.3 (CATHODE), U7.6 (GND); also elsewhere on the board
LED_DIN: LED1.1 (DIN); also elsewhere on the board
unnamed: LED1.3 (DOUT), LED2.1 (DIN)
unnamed: R6.2, U3.1 (ANODE)
unnamed: R1.2, U3.6 (OUTPUT)
unnamed: R5.2, U7.1 (ANODE)
unnamed: R15.2, U7.5 (OUTPUT)
VDC: C27.1, U6.2 (EN), U6.3 (IN); also elsewhere on the board

Notes on the sheet:
Magnetic Angle Sensor (IC using two internal hall sensors)
Side Facing Adressable LEDs (used for Iluminating the Z Probe during leveling)
Optical Endstops (endstop doubles as bed prope)
3.3V Linear Voltage Regulator (300mA for internal use only)
Caps could be added to filter input voltage, but we should already have sufficient bulk filtering close by
5V DC-DC Converter (compact 2A max Version)

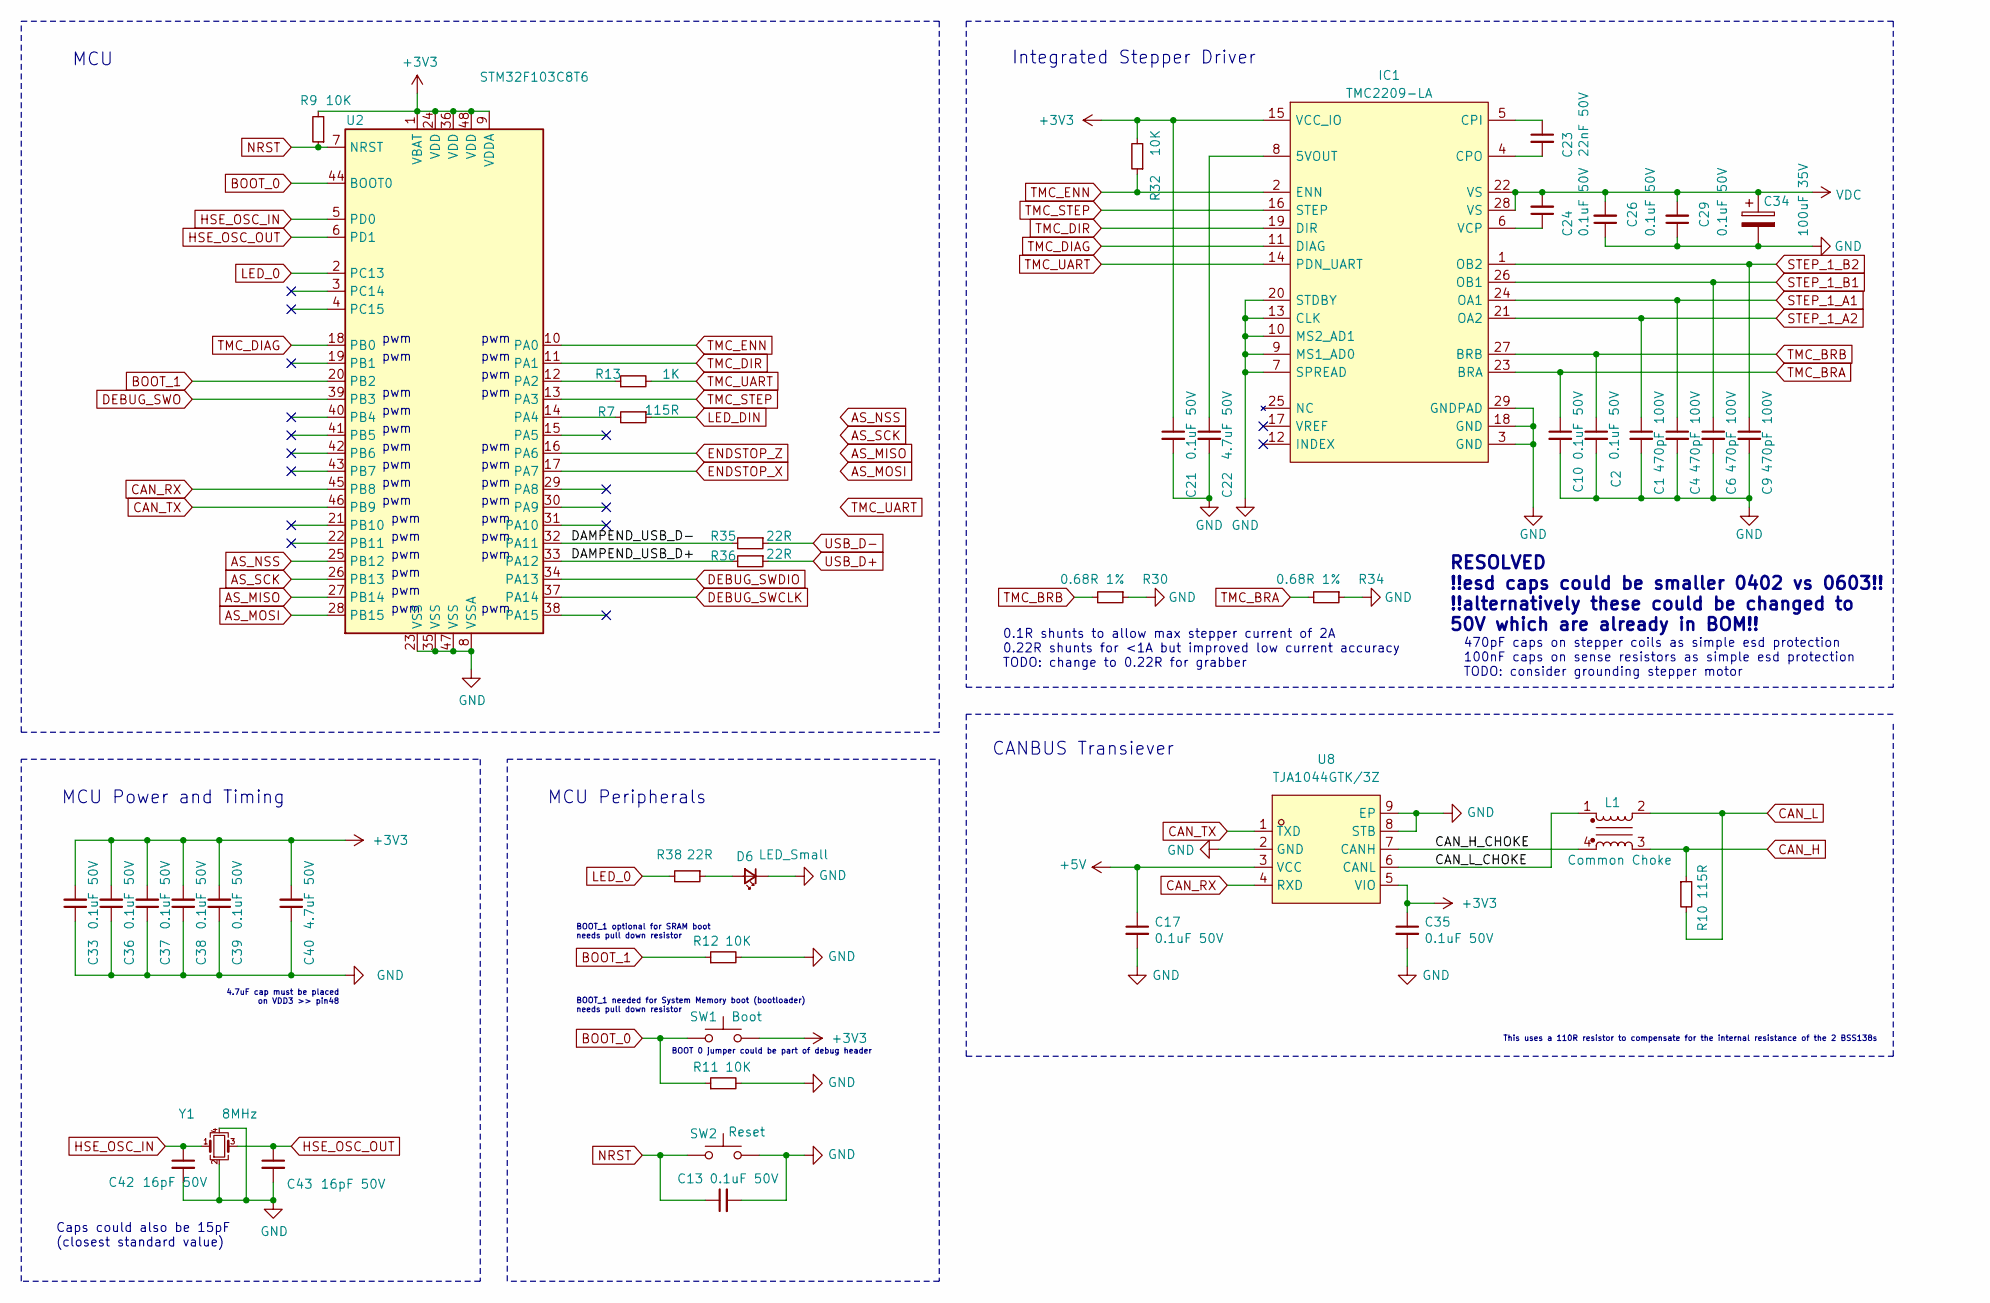
[picture p50: schematic MCU.kicad_sch, MCU & ICS]

Parts:
C1, C4, C6, C9: 470pF 100V; C_0603_1608Metric; LCSC C326973
C2, C10, C13, C17, C21, C24, C26, C29, C33, C35, C36, C37, C38, C39: 0.1uF 50V; C_0402_1005Metric; LCSC C5182432
C22, C40: 4.7uF 50V; C_0603_1608Metric; LCSC C513577
C23: 22nF 50V; C_0402_1005Metric; LCSC C107026
C34: 100uF 35V; CP_Elec_6.3x7.7; LCSC C2983388
C42, C43: 16pF 50V; C_0402_1005Metric; LCSC C513591
D6: LED_Small; LED_0402_1005Metric; LCSC C130724
IC1: TMC2209-LA; tmc_2209_package; LCSC C2150710
L1: Common Choke; L_CommonModeChoke_Coilcraft_0805USB; LCSC C3029267
R7, R10: 115R; R_0402_1005Metric; LCSC C295872
R9, R11, R12, R32: 10K; R_0402_1005Metric; LCSC C60490
R13: 1K; R_0402_1005Metric; LCSC C106235
R30, R34: 0.68R 1%; R_0805_2012Metric; LCSC C912570
R35, R36, R38: 22R; R_0402_1005Metric; LCSC C6117700
SW1: Boot; KEY-SMD_B3U-1000PM; LCSC C231329
SW2: Reset; KEY-SMD_B3U-1000PM; LCSC C231329
U2: STM32F103C8T6; LQFP-48_7x7mm_P0.5mm; LCSC C8734
U8: TJA1044GTK/3Z; HVSON-8-1EP_3x3mm_P0.65mm_EP1.6x2.4mm; LCSC C2157795
Y1: 8MHz; Crystal_SMD_3225-4Pin_3.2x2.5mm; LCSC C5261255

Connections:
+3V3: C21.1, C33.2, C35.1, C36.2, C37.2, C38.2, C39.2, C40.2, IC1.15 (VCC_IO), R9.2, R32.2, SW1.2, U2.1 (VBAT), U2.9 (VDDA), U2.24 (VDD), U2.36 (VDD), U2.48 (VDD), U8.5 (VIO); also elsewhere on the board
+5V: C17.1, U8.3 (VCC); also elsewhere on the board
/MCU/CAN_H_CHOKE: L1.4, U8.7 (CANH)
/MCU/CAN_L_CHOKE: L1.1, U8.6 (CANL)
/MCU/DAMPEND_USB_D+: R36.2, U2.33 (PA12)
/MCU/DAMPEND_USB_D-: R35.2, U2.32 (PA11)
AS_MISO: U2.27 (PB14); also elsewhere on the board
AS_MOSI: U2.28 (PB15); also elsewhere on the board
AS_NSS: U2.25 (PB12); also elsewhere on the board
AS_SCK: U2.26 (PB13); also elsewhere on the board
BOOT_0: R11.1, SW1.1, U2.44 (BOOT0)
BOOT_1: R12.1, U2.20 (PB2)
CAN_H: L1.3, R10.1; also elsewhere on the board
CAN_L: L1.2, R10.2; also elsewhere on the board
CAN_RX: U2.45 (PB8), U8.4 (RXD)
CAN_TX: U2.46 (PB9), U8.1 (TXD)
DEBUG_SWCLK: U2.37 (PA14); also elsewhere on the board
DEBUG_SWDIO: U2.34 (PA13); also elsewhere on the board
DEBUG_SWO: U2.39 (PB3); also elsewhere on the board
ENDSTOP_X: U2.17 (PA7); also elsewhere on the board
ENDSTOP_Z: U2.16 (PA6); also elsewhere on the board
GND: C1.2, C2.2, C4.2, C6.2, C9.2, C10.2, C13.2, C17.2, C21.2, C22.2, C26.1, C29.1, C33.1, C34.2, C35.2, C36.1, C37.1, C38.1, C39.1, C40.1, C42.2, C43.2, D6.1 (K), IC1.3 (GND), IC1.7 (SPREAD), IC1.9 (MS1_AD0), IC1.10 (MS2_AD1), IC1.13 (CLK), IC1.18 (GND), IC1.20 (STDBY), IC1.29 (GNDPAD), R11.2, R12.2, R30.1, R34.1, SW2.2, U2.8 (VSSA), U2.23 (VSS), U2.35 (VSS), U2.47 (VSS), U8.2 (GND), U8.8 (STB), U8.9 (EP), Y1.2, Y1.4; also elsewhere on the board
HSE_OSC_IN: C42.1, U2.5 (PD0), Y1.1
HSE_OSC_OUT: C43.1, U2.6 (PD1), Y1.3
LED_0: R38.2, U2.2 (PC13)
LED_DIN: R7.1; also elsewhere on the board
NRST: C13.1, R9.1, SW2.1, U2.7 (NRST); also elsewhere on the board
unnamed: D6.2 (A), R38.1
unnamed: C22.1, IC1.8 (5VOUT)
unnamed: C23.1, IC1.5 (CPI)
unnamed: C23.2, IC1.4 (CPO)
unnamed: C24.1, IC1.6 (VCP)
unnamed: R13.1, U2.12 (PA2)
unnamed: R7.2, U2.14 (PA4)
STEP_1_A1: C4.1, IC1.24 (OA1); also elsewhere on the board
STEP_1_A2: C1.1, IC1.21 (OA2); also elsewhere on the board
STEP_1_B1: C6.1, IC1.26 (OB1); also elsewhere on the board
STEP_1_B2: C9.1, IC1.1 (OB2); also elsewhere on the board
TMC_BRA: C10.1, IC1.23 (BRA), R34.2
TMC_BRB: C2.1, IC1.27 (BRB), R30.2
TMC_DIAG: IC1.11 (DIAG), U2.18 (PB0)
TMC_DIR: IC1.19 (DIR), U2.11 (PA1)
TMC_ENN: IC1.2 (ENN), R32.1, U2.10 (PA0)
TMC_STEP: IC1.16 (STEP), U2.13 (PA3)
TMC_UART: IC1.14 (PDN_UART), R13.2
USB_D+: R36.1; also elsewhere on the board
USB_D-: R35.1; also elsewhere on the board
VDC: C24.2, C26.2, C29.2, C34.1, IC1.22 (VS), IC1.28 (VS); also elsewhere on the board

Notes on the sheet:
pwm
RESOLVED !!esd caps could be smaller 0402 vs 0603!! !!alternatively these could be changed to 50V which are already in BOM!!
0.1R shunts to allow max stepper current of 2A 0.22R shunts for <1A but improved low current accuracy TODO: change to 0.22R for grabber
Caps could also be 15pF (closest standard value)
BOOT_1 optional for SRAM boot needs pull down resistor
MCU Power and Timing
This uses a 110R resistor to compensate for the internal resistance of the 2 BSS138s
Integrated Stepper Driver
4.7uF cap must be placed on VDD3 >> pin48
470pF caps on stepper coils as simple esd protection 100nF caps on sense resistors as simple esd protection TODO: consider grounding stepper motor
BOOT 0 jumper could be part of debug header
MCU Peripherals
BOOT_1 needed for System Memory boot (bootloader) needs pull down resistor
CANBUS Transiever
MCU
