VortacDesign/VortacToolchanger/pcb/KiCAD/VORTAC_REV1/VORTAC_REV1.kicad_pcb

## KiCad design pcb/KiCAD/VORTAC_REV1/VORTAC_REV1.kicad_pcb (continued)

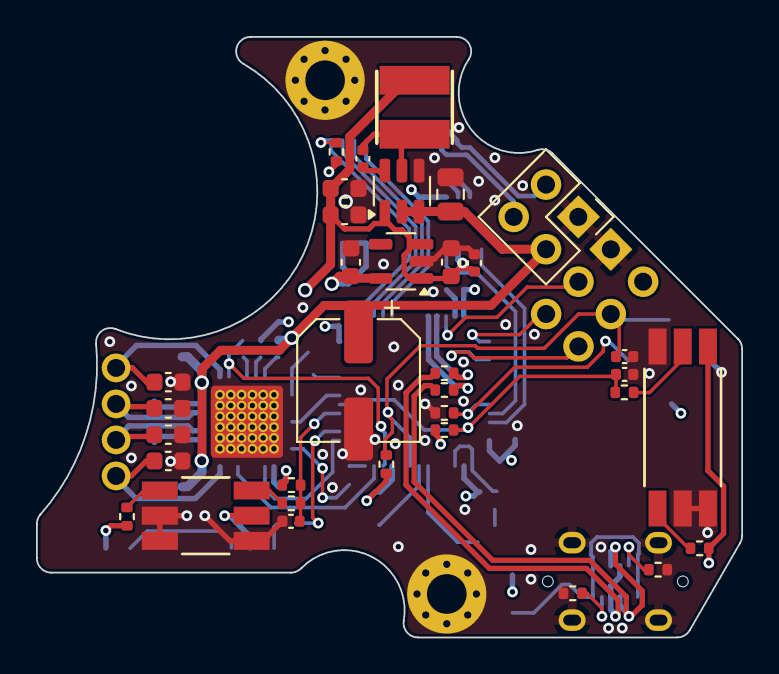
[picture p51: board VORTAC_REV1.kicad_pcb from above]

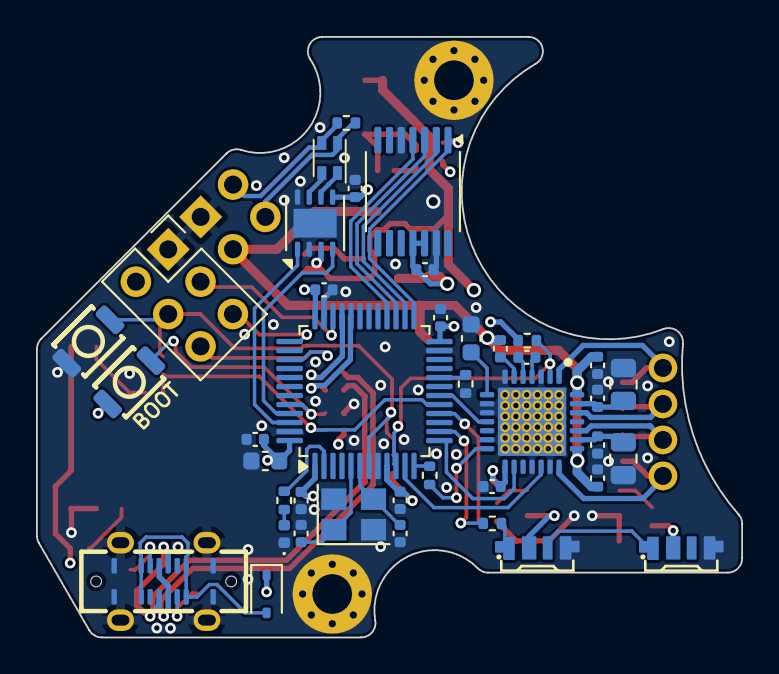
[picture p52: board VORTAC_REV1.kicad_pcb from below]

Board: 4 copper layers, 39.2 x 33.4 mm, 77 parts (40 on the bottom side), 58 nets.
