VortacDesign/VortacToolchanger/(commit log)

2025-06-08 init with PCB-Files
    [Headers.kicad_sch, Headers.sch, Logic.kicad_sch, Logic.sch, MCU.kicad_sch, MCU.sch, PCB Main.dxf, PCB Clearance.dxf]
2025-06-09 some stls
    [JointX_L_Bot_V3.stl, JointX_L_Top_V3.stl, JointX_R_Bot_V3.stl, JointX_R_Top_V3.stl, Sensor_Flag.stl, Sensor_Guide.stl, Vortac_001_Back.stl, Vortac_001_Top.stl]
2025-06-15 Cleaned up old and intermediate files from pcb repo
    [Headers.sch, Logic.sch, MCU.sch, VORTAC_FRONT_REV1.kicad_pcb, VORTAC_REV1.sch, Vortac_Panel_Rev1BoardOnly.step, Vortac_Panel_Rev1ToolBoardOnly.step, Vortac_Panel_TestPanel.step]
2025-10-04 Added Dock PCB
    [VORTAC_DOCK_REV1.kicad_pcb, VORTAC_DOCK_REV1.kicad_sch, VORTAC_DOCK_REV1.step, VORTAC_TOOLPLATE_REV1.kicad_pcb, VORTAC_TOOLPLATE_REV1.kicad_sch]
2025-10-04 init Vortac_Tool
    [OutLine.dxf, VORTAC_TOOL.kicad_pcb, VORTAC_TOOL.kicad_sch, VORTAC_TOOL.step, Vortac_Baseplate_003.stl, Vortac_Cable_Anchor_001.stl, Vortac_Topplate_003.stl]
2025-10-04 new Footprints and replaced chonky connectors
    [VORTAC_DOCK_REV1.kicad_pcb, VORTAC_DOCK_REV1.kicad_sch]
2025-10-27 Vortac Dock rough component placement #NO-JIRA
    [PCB_Outline.dxf, PCB_Refference.dxf, VORTAC_DOCK_REV1.kicad_pcb, VORTAC_DOCK_REV1.kicad_sch, VORTAC_DOCK_REV1.step]
2025-10-29 Check Lcsc numbers
    [VORTAC_DOCK_REV1.kicad_sch, VORTAC_TOOL.kicad_sch, bom.csv, designators.csv, positions.csv]
2025-10-29 Updated PCB Outline and Refferences based on CAD
    [PCB_Outline.dxf, PCB_Refference.dxf, VORTAC_DOCK_REV1.kicad_pcb]
2025-10-30 updateting Custom Foorprints to show Ref**
    [VORTAC_TOOL.kicad_pcb, VORTAC_TOOL.kicad_sch, bom.csv, designators.csv, positions.csv]
2025-10-30 Update SolderPads
2025-10-30 removed SolderMask
2025-10-30 Routed Vortac Dock PCB REV1
    [VORTAC_DOCK_REV1.kicad_pcb, VORTAC_DOCK_REV1.kicad_sch, VORTAC_DOCK_REV1.step]
2025-11-01 update footprint
2025-11-01 Added VORTAC_TOOLPLATE_REV2
    Modified VORTAC_TOOL
    [PCB_Outline.dxf, PCB_Refference.dxf, VORTAC_DOCK_REV1.kicad_pcb, VORTAC_TOOL.kicad_pcb, VORTAC_TOOL.step, VORTAC_TOOLPLATE_REV2.kicad_pcb, VORTAC_TOOLPLATE_REV2.kicad_sch, VORTAC_TOOLPLATE_REV2.step]
2025-11-02 (Hopefully) Finalized DOCK, TOOL and TOOLPLATE REV2 for ordering
    [VORTAC_DOCK_REV1.kicad_pcb, VORTAC_TOOL.kicad_pcb, VORTAC_TOOL.kicad_sch, VORTAC_TOOLPLATE_REV2.kicad_pcb, VORTAC_TOOLPLATE_REV2.kicad_sch]
2025-11-02 Production Files
    [VORTAC_DOCK_REV1.kicad_sch, VORTAC_TOOLPLATE_REV2.kicad_pcb, bom.csv, designators.csv, positions.csv]
2026-04-22 Doc Rev1 revision
    [SolderJig.stl, SolderJig_Magnets.stl, SolderJig_spachelor.stl, VORTAC_DOCK_REV1.kicad_pcb, VORTAC_DOCK_REV1.kicad_sch, VORTAC_DOCK_REV1.step, VORTAC_TOOL.step, bom.csv]
2026-04-23 Added Dock STLs and updated Dock PCB STEP to match the newest itteration
    [VORTAC_DOCK_REV1.step, Vortac_Dock_02_Frame.stl, Vortac_Dock_02_PogoBar.stl, Vortac_Dock_02_Slider.stl]
